galenandrew/wills-loft-bed/materials/materials-list.xlsx

Sheet: Buy list
Stock | Species / grade | Length | Qty | Unit | Notes
2x10 | TBD | 8 ft | 1 | board | 2 pieces total, longest 47
2x12 | TBD | 8 ft | 3 | board | 3 pieces total, longest 72¾
2x2 | TBD | 10 ft | 2 | board | 5 pieces total, longest 106¼ · LONGEST PIECE NEEDS A 10 FT BOARD · these two are ledge_cleat and ledge_cleat_rail; per the user they can be RIPPED from one 10 ft 2x4 instead
2x4 | TBD | 8 ft | 14 | board | 48 pieces total
2x4 | TBD | 10 ft | 1 | board | 48 pieces total, longest 104¾ · LONGEST PIECE NEEDS A 10 FT BOARD
2x8 | TBD | 8 ft | 1 | board | 4 pieces total, longest 23¼
poplar-2x2 | TBD | 8 ft | 8 | board | 23 pieces total, longest 26¼ · buy as poplar 8/4 S4S dressed to 1½ x 1½, or clear/select pine at that section — ONE board, no splice
poplar-2x4 | TBD | 10 ft | 1 | board | 1 pieces total, longest 107 · LONGEST PIECE NEEDS A 10 FT BOARD · buy as poplar 8/4 S4S dressed to 1½ x 3½, or clear/select pine at that section — ONE board, no splice
ply-1/2 | TBD | 4 x 8 sheet | 5 | sheet | 19 pieces nested at 61% of sheet area; 62.08 sq ft offcut · see the sheet nest — the Cut layout tab here, the Cut list page on the site
ply-3/4 paint-grade | TBD | 4 x 8 sheet | 4 | sheet | 22 pieces nested at 73% of sheet area; 34 1/16 sq ft offcut · see the sheet nest — the Cut layout tab here, the Cut list page on the site
lvl-2x14 | LVL (1 3/4 x 14) | 10 ft preferred | 1 | board | the beam is ONE 106 1/4 notched board. Home Depot stocks 14 ft (LPLVL14-14) which works with 62 in of waste; a yard 10 ft is the clean buy. Do NOT cut it to two pieces.

Sheet: Cut list
Part | Qty | Assembly | Stock | Length | Width | Thick | Source | Notes
hw_header#2x10-loft, hw_header#2x10-stair | 2 | half_wall | 2x10 | 47 | 9¼ | 1½ | lamination of hw_header
stringer_a, stringer_b, stringer_c | 3 | stair | 2x12 | 72¾ | 11¼ | 1½ | yaml member | true notched profile, not the yaml bbox; INCLINED: 72¾ up the rake, and the bbox is not the board
ledge_cleat, ledge_cleat_rail | 2 | loft | 2x2 | 106¼ | 1½ | 1½ | yaml member
ledge_strut[0], ledge_strut[1], ledge_strut[2] | 3 | loft | 2x2 | 5¾ | 1½ | 1½ | yaml member
rear_ledger | 1 | loft | 2x4 | 104¾ | 3½ | 1½ | yaml member
hw_top_plate_1, hw_top_plate_2 | 2 | half_wall | 2x4 | 50 | 3½ | 1½ | yaml member
side_ledger | 1 | loft | 2x4 | 50 | 3½ | 1½ | yaml member
hw_king_a, hw_king_b | 2 | half_wall | 2x4 | 49¼ | 3½ | 1½ | yaml member
deck_joist[0] | 1 | loft | 2x4 | 48½ | 3½ | 1½ | yaml member | one notched board; the yaml carries it as deck_joist[0], deck_joist_tail
deck_joist[1], deck_joist[2], deck_joist[3], deck_joist[4], deck_joist[5], deck_joist[6], deck_joist[7], deck_joist[8], deck_rim | 9 | loft | 2x4 | 46¾ | 3½ | 1½ | yaml member
hw_trimmer_a, hw_trimmer_b | 2 | half_wall | 2x4 | 40 | 3½ | 1½ | yaml member
nk_bedwall_stud[0], nk_bedwall_stud[1], nk_bedwall_stud[2] | 3 | nook | 2x4 | 38½ | 3½ | 1½ | yaml member
hw_rake_nailer | 1 | half_wall | 2x4 | 38 5/16 | 3½ | 1½ | yaml member | true raked profile, not the yaml bbox; INCLINED: 38 5/16 up the rake, and the bbox is not the board
hw_bottom_plate_a, hw_bottom_plate_b | 2 | half_wall | 2x4 | 28¼ | 3½ | 1½ | yaml member
kicker | 1 | stair | 2x4 | 24¾ | 3½ | 1½ | yaml member
nk_bedwall_cap | 1 | nook | 2x4 | 24¾ | 3½ | 1½ | yaml member
lnd_joist[0], lnd_joist[1] | 2 | stair | 2x4 | 15 | 3½ | 1½ | yaml member
nk_shortwall_strut[0], nk_shortwall_strut[1], nk_shortwall_strut[2] | 3 | nook | 2x4 | 14.11 | 3½ | 1½ | yaml member | true raked profile, not the yaml bbox
stringer_a_skin_cleat | 1 | stair | 2x4 | 13.53 | 3½ | 1½ | yaml member | true raked profile, not the yaml bbox
deck_blocking[0], deck_blocking[1], deck_blocking[2], deck_blocking[3], deck_blocking[4], deck_blocking[5], deck_blocking[6], deck_blocking[7], deck_seam_blocking[0], deck_seam_blocking[1], deck_seam_blocking[2], deck_seam_blocking[3], deck_seam_blocking[4] | 13 | loft | 2x4 | 10½ | 3½ | 1½ | yaml member
lnd_blocking[0], lnd_blocking[1] | 2 | stair | 2x4 | 10 1/8 | 3½ | 1½ | yaml member
deck_blocking_end | 1 | loft | 2x4 | 5¾ | 3½ | 1½ | yaml member
lnd_ledger_bedwall, lnd_rim | 2 | stair | 2x8 | 23¼ | 7¼ | 1½ | yaml member
lnd_ledger_rightwall | 1 | stair | 2x8 | 18 | 7¼ | 1½ | yaml member
lnd_side_member | 1 | stair | 2x8 | 15 | 7¼ | 1½ | yaml member
beam | 1 | loft | lvl-2x14 | 106¼ | 14 | 1¾ | yaml member | one notched board; the yaml carries it as beam, beam_tongue
beam_wrap_face | 1 | loft | ply-1/2 | 107 | 14½ | ½ | yaml member | CUT AS 2 PIECES: 53½×14½ + 53½×14½ — joint on x 53 1/2, over deck_joist[4]
beam_wrap_top | 1 | loft | ply-1/2 | 107 | 2¾ | ½ | yaml member | CUT AS 2 PIECES: 53½×2¾ + 53½×2¾ — joint on x 53 1/2, with the face wrap
beam_wrap_inner | 1 | loft | ply-1/2 | 106¼ | 9¾ | ½ | yaml member | CUT AS 2 PIECES: 53 1/8×9¾ + 53 1/8×9¾ — joint on x 53 1/8, the ledge's joint line
loft_ceiling | 1 | loft | ply-1/2 | 102¼ | 50 | ½ | yaml member | CUT AS 3 PIECES: 38¼×50 + 36×50 + 28×50 — three pieces, seams on the joist centres at 38¼ and 74¼ — every ceiling seam is backed by a joist; clear of all downlights. Rev AZ: 1/2 ply, and 102¼ long not 102 — the half-wall's loft face went to 1/2 with it, so the last piece grew 1/4
hw_sheath_loft_a | 1 | half_wall | ply-1/2 | 53¾ | 4¼ | ½ | yaml member
hw_sheath_loft_head | 1 | half_wall | ply-1/2 | 53¾ | 45¾ | ½ | yaml member | one notched board; the yaml carries it as hw_sheath_loft_head, hw_sheath_loft_b
hw_end_cap | 1 | half_wall | ply-1/2 | 53¼ | 4¾ | ½ | yaml member | one notched board; the yaml carries it as hw_end_cap, hw_end_cap_foot
hw_header#ply-1/2 | 1 | half_wall | ply-1/2 | 47 | 9¼ | ½ | lamination of hw_header
hw_jamb_ply_a, hw_jamb_ply_b | 2 | half_wall | ply-1/2 | 40 | 3½ | ½ | yaml member
nk_soffit_rake | 1 | nook | ply-1/2 | 37.97 | 28¼ | ½ | yaml member | true raked profile, not the yaml bbox; INCLINED: 37.97 up the rake, and the bbox is not the board
nk_soffit_flat | 1 | nook | ply-1/2 | 28¼ | 14.01 | ½ | yaml member
nk_wrap_shortwall | 1 | nook | ply-1/2 | 28¼ | 16.07 | ½ | yaml member | true raked profile, not the yaml bbox
stringer_a_skin | 1 | stair | ply-1/2 | 24 | 22 | ½ | yaml member | true stepped outline, not the yaml bbox
ledge_lid | 1 | loft | ply-3/4 | 107 | 8 | ¾ | yaml member | CUT AS 2 PIECES: 53 1/8×8 + 53 7/8×8 — joint on x 53 1/8, over ledge_strut[1]; no splice needed
deck_ply | 1 | loft | ply-3/4 | 106¼ | 48¼ | ¾ | yaml member | CUT AS 3 PIECES: 62¼×24 + 62¼×24¼ + 44×48¼ — two rows to x 62¼ either side of the y-24 seam, then one full-depth 44 x 48¼ panel over the landing end; seam on joist 5's centre — all derived from the blocking
ledge_front_rail | 1 | loft | ply-3/4 | 106¼ | 10¼ | ¾ | yaml member | CUT AS 2 PIECES: 53 1/8×10¼ + 53 1/8×10¼ — joint on x 53 1/8 = centre of ledge_strut[1], backed by ledge_rail_splice
hw_sheath_stair | 1 | half_wall | ply-3/4 | 50 | 44¼ | ¾ | yaml member | one notched board; the yaml carries it as hw_sheath_stair, ledge_end_cap, beam_end_cap
nk_wrap_bedwall | 1 | nook | ply-3/4 | 41½ | 28¼ | ¾ | yaml member
lnd_ply | 1 | stair | ply-3/4 | 27 7/8 | 24 | ¾ | yaml member
riser[1] | 1 | stair | ply-3/4 | 25¼ | 7½ | ¾ | DERIVED in cad/model.py — not a yaml member | riser scheme: standard
riser[2], riser[3] | 2 | stair | ply-3/4 | 25¼ | 8¼ | ¾ | DERIVED in cad/model.py — not a yaml member | riser scheme: standard
tread[1] | 1 | stair | ply-3/4 | 25¼ | 9 1/8 | ¾ | DERIVED in cad/model.py — not a yaml member | 5 from the top; 1/8 nose past the riser
tread[2] | 1 | stair | ply-3/4 | 25¼ | 9 1/8 | ¾ | DERIVED in cad/model.py — not a yaml member | 4 from the top; 1/8 nose past the riser
tread[3] | 1 | stair | ply-3/4 | 25¼ | 9 1/8 | ¾ | DERIVED in cad/model.py — not a yaml member | 3 from the top; 1/8 nose past the riser; notched 3/4 at the half-wall end
riser[4], riser[5] | 2 | stair | ply-3/4 | 24 | 8¼ | ¾ | DERIVED in cad/model.py — not a yaml member | riser scheme: standard
riser[6] | 1 | stair | ply-3/4 | 24 | 8¼ | ¾ | DERIVED in cad/model.py — not a yaml member | landing face
tread[4] | 1 | stair | ply-3/4 | 24 | 9 1/8 | ¾ | DERIVED in cad/model.py — not a yaml member | 2 from the top; 1/8 nose past the riser
tread[5] | 1 | stair | ply-3/4 | 24 | 9 1/8 | ¾ | DERIVED in cad/model.py — not a yaml member | 1 from the top; 1/8 nose past the riser
ledge_rail_splice | 1 | loft | ply-3/4 | 10 | 7¼ | ¾ | yaml member
slat[0..22] | 23 | screen | poplar-2x2 | 26¼ | 1½ | 1½ | yaml member
screen_top_plate | 1 | screen | poplar-2x4 | 107 | 3½ | 1½ | yaml member

Sheet: Sheet goods
Panel | Stock | Long | Short | From a split? | Notes / joint
hw_sheath_loft_a | ply-1/2 | 53¾ | 4¼
hw_sheath_loft_head | ply-1/2 | 53¾ | 45¾ |  | one notched board; the yaml carries it as hw_sheath_loft_head, hw_sheath_loft_b
beam_wrap_face pc1 | ply-1/2 | 53½ | 14½ | YES | joint on x 53 1/2, over deck_joist[4]
beam_wrap_face pc2 | ply-1/2 | 53½ | 14½ | YES | joint on x 53 1/2, over deck_joist[4]
beam_wrap_top pc1 | ply-1/2 | 53½ | 2¾ | YES | joint on x 53 1/2, with the face wrap
beam_wrap_top pc2 | ply-1/2 | 53½ | 2¾ | YES | joint on x 53 1/2, with the face wrap
hw_end_cap | ply-1/2 | 53¼ | 4¾ |  | one notched board; the yaml carries it as hw_end_cap, hw_end_cap_foot
beam_wrap_inner pc1 | ply-1/2 | 53 1/8 | 9¾ | YES | joint on x 53 1/8, the ledge's joint line
beam_wrap_inner pc2 | ply-1/2 | 53 1/8 | 9¾ | YES | joint on x 53 1/8, the ledge's joint line
loft_ceiling pc1 | ply-1/2 | 50 | 38¼ | YES | three pieces, seams on the joist centres at 38¼ and 74¼ — every ceiling seam is backed by a joist; clear of all downlights. Rev AZ: 1/2 ply, and 102¼ long not 102 — the half-wall's loft face went to 1/2 with it, so the last piece grew 1/4
loft_ceiling pc2 | ply-1/2 | 50 | 36 | YES | three pieces, seams on the joist centres at 38¼ and 74¼ — every ceiling seam is backed by a joist; clear of all downlights. Rev AZ: 1/2 ply, and 102¼ long not 102 — the half-wall's loft face went to 1/2 with it, so the last piece grew 1/4
loft_ceiling pc3 | ply-1/2 | 50 | 28 | YES | three pieces, seams on the joist centres at 38¼ and 74¼ — every ceiling seam is backed by a joist; clear of all downlights. Rev AZ: 1/2 ply, and 102¼ long not 102 — the half-wall's loft face went to 1/2 with it, so the last piece grew 1/4
hw_header#ply-1/2 | ply-1/2 | 47 | 9¼ |  | lamination of hw_header
hw_jamb_ply_a | ply-1/2 | 40 | 3½
hw_jamb_ply_b | ply-1/2 | 40 | 3½
nk_soffit_rake | ply-1/2 | 37.97 | 28¼ |  | true raked profile, not the yaml bbox; INCLINED: 37.97 up the rake, and the bbox is not the board
nk_soffit_flat | ply-1/2 | 28¼ | 14.01
nk_wrap_shortwall | ply-1/2 | 28¼ | 16.07 |  | true raked profile, not the yaml bbox
stringer_a_skin | ply-1/2 | 24 | 22 |  | true stepped outline, not the yaml bbox
deck_ply pc1 | ply-3/4 | 62¼ | 24 | YES | two rows to x 62¼ either side of the y-24 seam, then one full-depth 44 x 48¼ panel over the landing end; seam on joist 5's centre — all derived from the blocking
deck_ply pc2 | ply-3/4 | 62¼ | 24¼ | YES | two rows to x 62¼ either side of the y-24 seam, then one full-depth 44 x 48¼ panel over the landing end; seam on joist 5's centre — all derived from the blocking
ledge_lid pc2 | ply-3/4 | 53 7/8 | 8 | YES | joint on x 53 1/8, over ledge_strut[1]; no splice needed
ledge_lid pc1 | ply-3/4 | 53 1/8 | 8 | YES | joint on x 53 1/8, over ledge_strut[1]; no splice needed
ledge_front_rail pc1 | ply-3/4 | 53 1/8 | 10¼ | YES | joint on x 53 1/8 = centre of ledge_strut[1], backed by ledge_rail_splice
ledge_front_rail pc2 | ply-3/4 | 53 1/8 | 10¼ | YES | joint on x 53 1/8 = centre of ledge_strut[1], backed by ledge_rail_splice
hw_sheath_stair | ply-3/4 | 50 | 44¼ |  | one notched board; the yaml carries it as hw_sheath_stair, ledge_end_cap, beam_end_cap
deck_ply pc3 | ply-3/4 | 48¼ | 44 | YES | two rows to x 62¼ either side of the y-24 seam, then one full-depth 44 x 48¼ panel over the landing end; seam on joist 5's centre — all derived from the blocking
nk_wrap_bedwall | ply-3/4 | 41½ | 28¼
lnd_ply | ply-3/4 | 27 7/8 | 24
riser[1] | ply-3/4 | 25¼ | 7½ |  | riser scheme: standard
riser[2] | ply-3/4 | 25¼ | 8¼ |  | riser scheme: standard
riser[3] | ply-3/4 | 25¼ | 8¼ |  | riser scheme: standard
tread[1] | ply-3/4 | 25¼ | 9 1/8 |  | 5 from the top; 1/8 nose past the riser
tread[2] | ply-3/4 | 25¼ | 9 1/8 |  | 4 from the top; 1/8 nose past the riser
tread[3] | ply-3/4 | 25¼ | 9 1/8 |  | 3 from the top; 1/8 nose past the riser; notched 3/4 at the half-wall end
riser[4] | ply-3/4 | 24 | 8¼ |  | riser scheme: standard
riser[5] | ply-3/4 | 24 | 8¼ |  | riser scheme: standard
riser[6] | ply-3/4 | 24 | 8¼ |  | landing face
tread[4] | ply-3/4 | 24 | 9 1/8 |  | 2 from the top; 1/8 nose past the riser
tread[5] | ply-3/4 | 24 | 9 1/8 |  | 1 from the top; 1/8 nose past the riser
ledge_rail_splice | ply-3/4 | 10 | 7¼

Sheet: Cut layout
Grade | Sheet | Piece | W | H | From edge X | From edge Y | Grain | Flag
ply-1/2 | 1 | hw_sheath_loft_head | 45¾ | 53¾ | 0 | 0 | rotated
ply-1/2 | 1 | hw_header#ply-1/2 | 47 | 9¼ | 0 | 53 7/8
ply-1/2 | 1 | hw_jamb_ply_a | 40 | 3½ | 0 | 63¼
ply-1/2 | 1 | hw_jamb_ply_b | 40 | 3½ | 0 | 66 7/8
ply-1/2 | 1 | nk_wrap_shortwall | 28¼ | 16.07 | 0 | 70½
ply-1/2 | 2 | hw_sheath_loft_a | 4¼ | 53¾ | 0 | 0 | rotated
ply-1/2 | 2 | beam_wrap_face pc1 | 14½ | 53½ | 4 3/8 | 0 | rotated
ply-1/2 | 2 | beam_wrap_face pc2 | 14½ | 53½ | 19 | 0 | rotated
ply-1/2 | 2 | beam_wrap_top pc1 | 2¾ | 53½ | 33 5/8 | 0 | rotated
ply-1/2 | 2 | beam_wrap_top pc2 | 2¾ | 53½ | 36½ | 0 | rotated
ply-1/2 | 2 | hw_end_cap | 4¾ | 53¼ | 39 3/8 | 0 | rotated
ply-1/2 | 2 | nk_soffit_rake | 37.97 | 28¼ | 4 3/8 | 53 5/8
ply-1/2 | 3 | beam_wrap_inner pc1 | 9¾ | 53 1/8 | 0 | 0 | rotated
ply-1/2 | 3 | beam_wrap_inner pc2 | 9¾ | 53 1/8 | 9 7/8 | 0 | rotated
ply-1/2 | 3 | loft_ceiling pc3 | 28 | 50 | 19¾ | 0
ply-1/2 | 3 | nk_soffit_flat | 28¼ | 14.01 | 0 | 53¼
ply-1/2 | 3 | stringer_a_skin | 24 | 22 | 0 | 67.39
ply-1/2 | 4 | loft_ceiling pc1 | 38¼ | 50 | 0 | 0
ply-1/2 | 5 | loft_ceiling pc2 | 36 | 50 | 0 | 0
ply-3/4 paint-grade | 1 | deck_ply pc2 | 24¼ | 62¼ | 0 | 0 | rotated
ply-3/4 paint-grade | 1 | ledge_lid pc2 | 8 | 53 7/8 | 24 3/8 | 0 | rotated
ply-3/4 paint-grade | 1 | ledge_front_rail pc1 | 10¼ | 53 1/8 | 32½ | 0 | rotated
ply-3/4 paint-grade | 1 | ledge_rail_splice | 10 | 7¼ | 32½ | 53¼
ply-3/4 paint-grade | 1 | nk_wrap_bedwall | 41½ | 28¼ | 0 | 62 3/8
ply-3/4 paint-grade | 2 | deck_ply pc1 | 24 | 62¼ | 0 | 0 | rotated
ply-3/4 paint-grade | 2 | ledge_front_rail pc2 | 10¼ | 53 1/8 | 24 1/8 | 0 | rotated
ply-3/4 paint-grade | 2 | ledge_lid pc1 | 8 | 53 1/8 | 34½ | 0 | rotated
ply-3/4 paint-grade | 2 | lnd_ply | 27 7/8 | 24 | 0 | 62 3/8
ply-3/4 paint-grade | 2 | tread[2] | 9 1/8 | 25¼ | 28 | 62 3/8 | rotated
ply-3/4 paint-grade | 2 | tread[3] | 9 1/8 | 25¼ | 37¼ | 62 3/8 | rotated
ply-3/4 paint-grade | 2 | tread[1] | 25¼ | 9 1/8 | 0 | 86½
ply-3/4 paint-grade | 3 | hw_sheath_stair | 44¼ | 50 | 0 | 0 | rotated
ply-3/4 paint-grade | 3 | riser[2] | 25¼ | 8¼ | 0 | 50 1/8
ply-3/4 paint-grade | 3 | riser[3] | 25¼ | 8¼ | 0 | 58½
ply-3/4 paint-grade | 3 | riser[1] | 25¼ | 7½ | 0 | 66 7/8
ply-3/4 paint-grade | 3 | riser[4] | 8¼ | 24 | 25 3/8 | 66 7/8 | rotated
ply-3/4 paint-grade | 3 | riser[5] | 8¼ | 24 | 33¾ | 66 7/8 | rotated
ply-3/4 paint-grade | 3 | tread[4] | 24 | 9 1/8 | 0 | 74½
ply-3/4 paint-grade | 3 | tread[5] | 24 | 9 1/8 | 0 | 83¾
ply-3/4 paint-grade | 4 | deck_ply pc3 | 44 | 48¼ | 0 | 0
ply-3/4 paint-grade | 4 | riser[6] | 24 | 8¼ | 0 | 48 3/8

Sheet: Hardware
Connection / item | Qty | Type | Fastener spec
LUS24 | 21 | Simpson
HUC28 | 2 | Simpson
A35 | 2 | Simpson
deck_joist[*] -> rear_ledger | 9 | hanger | LUS24
deck_joist[*] -> beam | 8 | hanger | LUS24 with 10dx1-1/2 into the beam — 1-1/2 of nail in 1-3/4 of LVL, the thickness the hanger tables are written for. Rev AG settles what Rev T left open; joist[0] is excepted because it runs past the beam face to y 50 and is carried by the side ledger.
beam_tongue -> side_ledger | 1 | bearing | bears on the ledger top at 57.25 over 1-1/2 x 1-3/4. Pinned with 2 x 1/4 x 6 structural screws driven UP from below, through the ledger's 3-1/2 into 2-1/2 of LVL — set the ledger and joist 0 first, drop the beam on, then screw from the open bay under the deck. NOT from above, the way this row read before the Rev AG connection audit, a 4 in screw from the beam's top face at 67.75 dies at 63.75 and never leaves the beam.
beam_tongue -> deck_joist_tail | 1 | bearing | bears on the sistered joist top over 1-1/2 x 1-3/4. Pinned the same way as the ledger half — 2 x 1/4 x 6 up through the joist tail from below. Ledger + joist together give the notched end 3 x 1-3/4 = 5.25 sq in, about 115 psi.
deck_joist[0] -> side_ledger | 1 | face-screw | 1/4 x 3 structural screws, two rows at 8 in o.c. over the whole 46-3/4 sister, with 4 in the last 12 — this is the path that takes joist[0]'s half of the beam reaction into the wall
deck_blocking[*] -> beam | 8 | face-screw | 2 x 1/4 x 3 structural screws per block at z 54 1/4 and 56 3/4, driven from the beam's OUTBOARD face at y 50 through 1 3/4 of LVL and 1 1/4 into the block. Rev AY: the z is stated because beam_wrap_face's structural rows come through the same face at the same x stations - keep them off each other. Rev AU: preferred over toe-screwing from inside the bay because it puts the fastener in shear instead of relying on a toed screw, and the y-50 face is open until beam_wrap_face goes on - the heads end up behind the wrap. SEQUENCE: before the wrap, and before the deck ply.
deck_blocking_end -> beam | 1 | face-screw | 2 x 1/4 x 3 structural screws from the beam's outboard face, as deck_blocking
deck_ply -> deck_blocking[*] | 8 | bearing | construction adhesive + #8 x 1-5/8 at 6 in o.c. along the front edge - the point of the blocking. This is the deck diaphragm's only continuous connection toward the beam (Rev AU)
deck_ply -> deck_blocking_end | 1 | bearing | construction adhesive + #8 x 1-5/8 at 6 in o.c., as deck_blocking
deck_seam_blocking[0] -> deck_joist[0] | 1 | face-screw | 2 x 3 in screws toe-driven into deck_joist[0]
deck_seam_blocking[0] -> deck_joist[1] | 1 | face-screw | 2 x 3 in screws toe-driven into deck_joist[1]. Rev AY: the far end used to be asserted in the other row's note and never checked. The block has no bearing shelf - it hangs at z 55.75-57.25 on toe-screws at BOTH ends - so both ends carry, and both are now declared.
deck_seam_blocking[1] -> deck_joist[1] | 1 | face-screw | 2 x 3 in screws toe-driven into deck_joist[1]
deck_seam_blocking[1] -> deck_joist[2] | 1 | face-screw | 2 x 3 in screws toe-driven into deck_joist[2]. Rev AY: the far end used to be asserted in the other row's note and never checked. The block has no bearing shelf - it hangs at z 55.75-57.25 on toe-screws at BOTH ends - so both ends carry, and both are now declared.
deck_seam_blocking[2] -> deck_joist[2] | 1 | face-screw | 2 x 3 in screws toe-driven into deck_joist[2]
deck_seam_blocking[2] -> deck_joist[3] | 1 | face-screw | 2 x 3 in screws toe-driven into deck_joist[3]. Rev AY: the far end used to be asserted in the other row's note and never checked. The block has no bearing shelf - it hangs at z 55.75-57.25 on toe-screws at BOTH ends - so both ends carry, and both are now declared.
deck_seam_blocking[3] -> deck_joist[3] | 1 | face-screw | 2 x 3 in screws toe-driven into deck_joist[3]
deck_seam_blocking[3] -> deck_joist[4] | 1 | face-screw | 2 x 3 in screws toe-driven into deck_joist[4]. Rev AY: the far end used to be asserted in the other row's note and never checked. The block has no bearing shelf - it hangs at z 55.75-57.25 on toe-screws at BOTH ends - so both ends carry, and both are now declared.
deck_seam_blocking[4] -> deck_joist[4] | 1 | face-screw | 2 x 3 in screws toe-driven into deck_joist[4]
deck_seam_blocking[4] -> deck_joist[5] | 1 | face-screw | 2 x 3 in screws toe-driven into deck_joist[5]. Rev AY: the far end used to be asserted in the other row's note and never checked. The block has no bearing shelf - it hangs at z 55.75-57.25 on toe-screws at BOTH ends - so both ends carry, and both are now declared.
deck_ply -> deck_seam_blocking[*] | 5 | bearing | construction adhesive + #8 x 1-5/8 at 6 in o.c. through BOTH panel edges - the seam is a butt joint in the deck diaphragm and both sides land on this block (Rev AV)
deck_ply -> side_ledger | 1 | bearing | construction adhesive + #8 x 1-5/8 at 6 in o.c. — structural, not just an edge fixing, because the ply diaphragm is what keeps the shallow ledger from rolling under the beam's eccentric load
deck_ply -> rear_ledger | 1 | bearing | construction adhesive + #8 x 1-5/8 at 6 in o.c., same as the side ledger — Rev AO drops rear_ledger to deck level so the ply runs over its top the same way
beam -> hw_top_plate_2 | 1 | bearing | NO FASTENER KEY — silent in verify.py, which only reports the rows that say UNSPECIFIED
deck_rim -> hw_top_plate_2 | 1 | bearing | NO FASTENER KEY — silent in verify.py, which only reports the rows that say UNSPECIFIED
rear_ledger -> wall:bed | 1 | wall | 3/8 x 4 lags, 2 per stud staggered, into every stud - the same fastener as lnd_ledger_bedwall. Rev AS: was the sizeless 'lags into every stud'. 1 1/2 of 2x4 ledger + 5/8 of board = 2 1/8 crossed, 1 7/8 of embedment.
side_ledger -> wall:window | 1 | wall | 1/4 x 4 structural screws, 2 per stud staggered top and bottom, plus a pair within 6 in of y 50 — FIELD, confirm a stud lands there or add blocking in the wall
hw_header -> hw_trimmer_a | 1 | bearing | NO FASTENER KEY — silent in verify.py, which only reports the rows that say UNSPECIFIED
hw_header -> hw_trimmer_b | 1 | bearing | NO FASTENER KEY — silent in verify.py, which only reports the rows that say UNSPECIFIED
hw_jamb_ply_a -> hw_bottom_plate_a | 1 | bearing | bears with the trimmer; held by the pack nailing below
hw_jamb_ply_b -> hw_bottom_plate_b | 1 | bearing | bears with the trimmer; held by the pack nailing below
hw_trimmer_a -> hw_king_a | 1 | face-screw | 16d nails in two rows at 12 in o.c. + construction adhesive on both faces of the ply — this is what makes the pack act as one 3.5 post
hw_trimmer_b -> hw_king_b | 1 | face-screw | 16d nails in two rows at 12 in o.c. + construction adhesive on both faces of the ply — this is what makes the pack act as one 3.5 post
hw_top_plate_2 -> hw_top_plate_1 | 1 | bearing | 16d at 16 in o.c., staggered — the upper plate laps the lower at the wall's ends
hw_king_a -> hw_bottom_plate_a | 1 | bearing | 2 x 3 in screws toe-driven, or end-nailed 2 x 16d through the plate
hw_king_b -> hw_bottom_plate_b | 1 | bearing | 2 x 3 in screws toe-driven, or end-nailed 2 x 16d through the plate. This is the stud the beam's stair-end reaction comes down; Rev AG's connection audit found the post asserted in prose and never declared.
hw_top_plate_1 -> hw_header | 1 | bearing | NO FASTENER KEY — silent in verify.py, which only reports the rows that say UNSPECIFIED
hw_top_plate_1 -> hw_king_a | 1 | bearing | NO FASTENER KEY — silent in verify.py, which only reports the rows that say UNSPECIFIED
hw_top_plate_1 -> hw_king_b | 1 | bearing | NO FASTENER KEY — silent in verify.py, which only reports the rows that say UNSPECIFIED
hw_bottom_plate_a -> floor | 1 | floor | 6 x #10 x 3 in screws into the subfloor at roughly 6 in o.c. across the 28 1/4 run. Rev BB: same builder's call as the kicker — into the plywood regardless of joist location, since the half-wall framing this plate carries is already tied into the bed wall and window wall.
hw_bottom_plate_b -> floor | 1 | floor | 6 x #10 x 3 in screws into the subfloor at roughly 6 in o.c. across the 28 1/4 run. Rev BB: same builder's call as hw_bottom_plate_a.
nk_bedwall_stud[*] -> hw_bottom_plate_a | 3 | bearing | 2 x 3 in screws toe-driven each stud
nk_bedwall_cap -> nk_bedwall_stud[*] | 3 | bearing | 2 x 3 in screws through the cap into each stud
lnd_ledger_bedwall -> nk_bedwall_cap | 1 | bearing | 3 in screws up through the cap into the ledger at each stud — secondary only, the ledger's own load path is its lags into the bed-wall studs
lnd_ledger_rightwall -> nk_bedwall_cap | 1 | bearing | 3 in screws up through the cap, at the cap's right-hand end
lnd_side_member -> nk_bedwall_cap | 1 | bearing | 2 x 3 in screws up through the cap into the side member
nk_shortwall_strut[*] -> hw_bottom_plate_b | 3 | bearing | 2 x 3 in screws toe-driven each strut
hw_rake_nailer -> hw_trimmer_b | 1 | face-screw | 3 x 3 in screws through the trimmer into the nailer's end
lnd_side_member -> hw_header | 1 | face-screw | 6 × 1/4 × 4 structural screws. Rev AE: direct into the header, no 3/4 facing in the path, so 4 in reaches the depth 5 in used to.
lnd_ledger_rightwall -> wall:right | 1 | wall | 1/4 x 4 flat-head structural screws (SDWS22400 or equal), 2 per stud staggered. Rev AS: the wall is 5/8 drywall on wood studs, so a screw crosses 1 1/2 of 2x8 ledger + 5/8 of board = 2 1/8 before it reaches the stud; a 4 leaves 1 7/8 of embedment. Do not substitute 3 1/2 here - that is only 1 3/8 in the stud.
stringer_c -> wall:right | 1 | wall | 1/4 x 4 flat-head structural screws, 2 per stud into every stud the stringer crosses. Rev AS: was the bare Rev T phrase 'fastens to the right wall', which specified nothing. Same 2 1/8 of ledger + board to cross as lnd_ledger_rightwall.
stringer_a_skin -> stringer_a | 1 | face-screw | construction adhesive + 1-1/2 x 16ga finish nails at 8 in o.c. into the stringer's outer face (1 in penetration through the 1/2 skin; was 3/4 through 3/4)
stringer_a_skin_cleat -> stringer_a_skin | 1 | face-screw | 1-1/2 x 16ga finish nails at 8 in o.c. through the skin into the cleat, plus adhesive
stringer_a_skin_cleat -> hw_bottom_plate_b | 1 | face-screw | 2 x #10 x 3 screws through the plate's end into the cleat
stringer_a_skin_cleat -> stringer_a | 1 | bearing | adhesive + 3 x #10 x 2-1/2 screws up through the cleat's ripped top into the stringer, over the 5 in of angled contact at its downhill end
stringer_a_skin_cleat -> floor | 1 | floor | 3 x #10 x 3 screws into the subfloor
kicker -> floor | 1 | floor | 5 x #10 x 3 in screws into the subfloor, roughly 6 in o.c. across the 24 3/4 run. Floor joist location not measured and not required here: the builder's call (Rev BB) is to fasten straight into the plywood subfloor regardless of where the joists fall, since the framing is tied into all three walls in several other places and does not depend on this fixing to stay put.
stringer_a -> kicker | 1 | bearing | 2 x 3 in screws toe-driven into the kicker
stringer_b -> kicker | 1 | bearing | 2 x 3 in screws toe-driven into the kicker
stringer_c -> kicker | 1 | bearing | 2 x 3 in screws toe-driven into the kicker
loft_ceiling -> deck_joist[*] | 9 | face-screw | construction adhesive + #8 x 2 at 8 in o.c. up into each joist's 1-1/2 bottom edge - 1/2 of ply then 1-1/2 into 3-1/2 of joist (Rev AZ: 1/2 ply, so the same screw takes 1/4 MORE embedment). Rev AT: the panel had NO connection row of any kind before this.
loft_ceiling -> rear_ledger | 1 | face-screw | construction adhesive + #8 x 2 at 8 in o.c. into the ledger's bottom edge
loft_ceiling -> side_ledger | 1 | face-screw | construction adhesive + #8 x 2 at 6 in o.c. into the ledger's bottom edge over the whole 50. Rev AT: tighter than the 8 in field spacing because this is the anchored side of the notch tie - see the beam row below.
loft_ceiling -> deck_joist_tail | 1 | face-screw | construction adhesive + 2 x #8 x 2 into the tail's 1-3/4 of bottom edge, the other anchored side of the notch tie (Rev AT)
loft_ceiling -> beam | 1 | face-screw | construction adhesive + #8 x 2 at 6 in o.c. into the beam's bottom edge over x 3 to 27, then 12 in o.c. beyond. Rev AT: this is the SECOND notch restraint, and it acts in the direction the notch would actually fail. A split from the corner at x 3, z 57.25 runs in +x along the grain, and the piece it separates is the beam's bottom 3-1/2 beyond x 3 - whose bottom face is this z 53.75 line. The same sheet is screwed to side_ledger and deck_joist_tail on the other side of x 3, both solidly bearing, so it is a continuous tie holding that piece up against members that cannot move. It is SECONDARY to beam_wrap_face, which is in the plane of the split and works in shear; this works in screw withdrawal from a 1-3/4 landing that is the LVL's LAMINATED EDGE - screws there cross glue lines, so use the stated spacing, do not over-torque, and do not treat this as the primary. Both go on late, so neither is present while the loft is being framed.
beam_wrap_face -> beam | 1 | face-screw | construction adhesive + #8 x 2 at 12 in o.c. in two rows into the LVL - 1/2 of ply then 1-1/2 into 1-3/4 of beam (Rev AZ: the splice screws GAINED 1/4 of embedment on the thinner panel; nothing about the splice got weaker). Rev AT: OVER x 0 TO 27 THIS IS STRUCTURAL, not a finish fixing: tighten to 6 in o.c. in two rows and glue the full contact area. This panel is the notch reinforcement (see beam_tongue) - it straddles the re-entrant corner at x 3, z 57.25 and runs the full length past the shoulder, so it carries across the corner in shear what the LVL would otherwise carry in cross-grain tension. Keep every screw at least 1 in clear of the corner and out of the notch void below z 57.25 at x 0-3. Rev AT: the wrap had no connection row at all before this - its fixing was never specified and never checked.
beam_wrap_face -> beam_tongue | 1 | face-screw | glue only over x 0 to 3 - no screws within 1 in of the notch corner at x 3, z 57.25, which is what the beam row already says. Rev AY: this row exists so the arithmetic covers the whole board. beam_tongue is part_of beam - the SAME LVL - but resolve() does not merge part_of members, so beam_wrap_face -> beam checked only 103 1/4 of the 106 1/4 and the 3 the splice exists to protect sat outside every overlap number reported. Found by connection-checker at Rev AX. No physical change: the wood is continuous across x 3 above z 57.25, and the tongue has its own verified gravity path onto side_ledger and deck_joist_tail.
beam_wrap_face -> side_ledger | 1 | face-screw | #8 x 2-1/2 at 6 in o.c. into the ledger's y-50 end face, over z 53.75-57.25. Rev AT: part of the notch splice - this is what ties the tongue back to the member it bears on. End-grain withdrawal is poor and irrelevant here: the joint works in shear. Rev AY: 2-1/2 not 2, for 1-3/4 of embedment instead of 1-1/4; Rev AZ makes it 2 on the 1/2 wrap. This is the anchor side of the whole splice claim and 1-1/4 of dowel action in end grain was thin.
beam_wrap_face -> deck_joist_tail | 1 | face-screw | #8 x 2-1/2 at 6 in o.c. into the tail's y-50 end face, over z 53.75-57.25 - the other half of the notch splice, into the joist sistered to the ledger (Rev AT; 2-1/2 since Rev AY, same end-grain reason as the ledger half)
beam_wrap_inner -> beam | 1 | face-screw | construction adhesive + #8 x 2 at 12 in o.c. into the LVL. Rev AT: finish fixing only - this panel starts at z 58, 3/4 above the notch corner, so it does no structural work and is not part of the splice. It had no connection row either.
beam_wrap_top -> beam | 1 | bearing | construction adhesive + #8 x 2 at 12 in o.c. into the LVL, between the slats. The cap is finish stock doing structural work - it is the slats' seat - so it is fixed on its own account, not by the slat screws alone.
slat[*] -> beam_wrap_top | 22 | bearing | 1 x #8 x 3 through the cap into the LVL — 1/2 of cap since Rev AZ, 2-1/2 into the beam. Rev AG settles what Rev T left open. slat[22] is the one exception - see below.
slat[22] -> beam_wrap_top | 1 | bearing | 1 x #8 x 3, OFFSET INBOARD. slat[22] runs x 105.5 to 107 and the LVL ends at 106.25, so only 3/4 of its 1-1/2 width has beam under the cap - the rest is over beam_end_cap, which is still 3/4 ply. A centred screw lands half in ply. Found by the kernel ray cast.
ledge_cleat -> wall:bed | 1 | wall | 2 x 3 in screws into every stud — it carries half an 8 wide lid and whatever is set on it, so it is fixed like a ledger, not tacked like trim
ledge_strut[*] -> ledge_cleat | 3 | face-screw | 2 x #8 x 2-1/2 toe-driven into the cleat, plus adhesive
ledge_strut[*] -> ledge_front_rail | 3 | face-screw | adhesive + 2 pocket screws from inside the well, angled out of the strut into the back of the rail. Pocket, not toe: a toe screw into the 3/4 rail from behind breaks out the face, and a screw through the rail's face lands in the strut's end grain. (Rev BA: said "3/4 of poplar"; the rail has been 3/4 paint-grade ply since Rev AS. Same detail, same reason - a ply face breaks out at least as readily.)
ledge_lid -> ledge_strut[*] | 3 | bearing | #8 x 1-1/4, 2 per strut, countersunk and filled
ledge_lid -> ledge_cleat | 1 | bearing | #8 x 1-1/4 at 12 in o.c., countersunk and filled — the lid is fixed, not hinged
ledge_cleat_rail -> ledge_front_rail | 1 | face-screw | construction adhesive + #8 x 1-1/4 at 12 in o.c. from inside the well, through the cleat into the rail — screwed from the back so nothing shows on the face
ledge_cleat_rail -> deck_ply | 1 | bearing | construction adhesive + #10 x 3-1/2 down through the cleat and the ply into a joist at each of the 9 joists, and #8 x 2 into the ply between them
ledge_lid -> ledge_front_rail | 1 | bearing | #8 x 1-1/4 at 12 in o.c. into the rail's 3/4 top edge, countersunk and filled. Rev AM: the lid is fixed, never hinged, so this joint is permanent - and with the three struts holding the rail's top on 7.25 it is a flush line the whole 106 1/4, not a joint that has to be pulled closed at assembly.
ledge_rail_splice -> ledge_front_rail | 1 | face-screw | construction adhesive + #8 x 1-1/4 at 6 in o.c. in two rows, from inside the well through the splice into the back of both rail pieces - 1/2 into the rail's 3/4
ledge_lid -> ledge_end_cap | 1 | bearing | #8 x 1-1/4, 2 off — the 3/4 x 8 of skirt top edge the lid laps at the stair end (Rev AH)
screen_top_plate -> slat[*] | 23 | bearing | construction adhesive + 1 x #8 x 2-1/2 angled up through the slat into the plate, driven from the loft side, countersunk and filled; 2 x 1-1/2 16ga pins each slat to hold it while the adhesive cures. Rev AS: was UNSPECIFIED. 16ga alone was proposed and is not enough - the structure table calls this screen the GUARD for a 58 deck, and the ceiling note says a 200 lb lean at its top overloads the slat bases. One real screw per slat at each end (the base already has #8 x 3 into the LVL) makes the top a positive connection; the pins are for assembly, not for load.
screen_top_plate -> ceiling | 1 | ceiling | into ceiling framing / blocking — joist location not yet measured
lnd_ledger_bedwall -> wall:bed | 1 | wall | 3/8 x 4 lags, 2 per stud
stringer_b -> lnd_rim | 1 | face-screw | 3 x 1/4 x 3-1/2 SDS from inside the box through the rim, before the deck goes on
stringer_c -> lnd_ledger_rightwall | 1 | face-screw | plumb cut on the ledger end + 4 x 1/4 x 4-1/2 SDS into right-wall studs
stringer_a -> hw_header | 1 | face-screw | 4 x 1/4 x 3-1/2 SDS over y 18-27. Rev AE: the stringer is on the framing now, not on 3/4 of ply, so a 3-1/2 buries 2 in the header.
stringer_a -> hw_king_b | 1 | face-screw | 2 x 1/4 x 3-1/2 SDS
stringer_a -> hw_trimmer_b | 1 | face-screw | 2 x 1/4 x 3-1/2 SDS. Rev AE: the stringer crosses the far jamb pack over z 12-24, so it catches the trimmer as well as the king.
hw_rake_nailer -> stringer_a | 1 | face-screw | construction adhesive + 6 x 3 in screws toe-driven through the nailer into the stringer's face. Rev AE: the nailer's raked end (1-1/2 x 30 on the slope) dies straight onto stringer A now that the sheathing between them is gone.
lnd_rim -> hw_header | 1 | hanger | HUC28 concealed-flange hanger, SD10212 screws straight into the header (flanges would foul the side member on an LUS). Rev AE: no 3/4 facing in the path.
lnd_rim -> lnd_ledger_rightwall | 1 | hanger | HUC28 concealed-flange hanger (an LUS flange would hang past the ledger end)
lnd_joist[*] -> lnd_ledger_bedwall | 2 | hanger | LUS24
lnd_joist[*] -> lnd_rim | 2 | hanger | LUS24 on the rim's back face
lnd_side_member -> lnd_rim | 1 | face-screw | 2 x A35 at the inside corner, installed before the joists
stringer_a -> lnd_rim | 1 | face-screw | 2 x 1/4 x 3-1/2 SDS toe-screwed from the stringer's outer face; the side member blocks access from inside the box
lnd_blocking[*] -> stringer_b | 2 | face-screw | 2 x 3 in screws each end, toe-driven

Sheet: TBD and assumptions
Kind | Item | Detail
SOURCE | Generated from dimensions.yaml rev BC.1 | tools/materials.py, off the same model verify.py and the CAD kernel read. Regenerate after ANY model change — nothing here updates itself, and a stale workbook looks exactly like a current one.
CLOSED | Deck and ceiling ply layouts, chosen for joinery (Rev AX) | The deck is THREE pieces: two rows to x 62 1/4 either side of a blocked cross-joist seam at y 24, then one full-depth 44 x 48 1/4 panel over the landing end with no seam in it — the part walked on rather than slept on. Both seams sit under the mattress; the long one lands on joist 5 and needs no blocking. 62 1/4 is the furthest in it can go: the next joist would need a 56 wide panel against a 48 sheet width. The ceiling is three pieces with BOTH seams on joist centres (38 1/4, 74 1/4), so every ceiling seam is backed. Trimming the deck to a flat 48 was considered and rejected — it changed no sheet count and would have left beam_wrap_inner's foot over a 1/4 void. COST, stated plainly: these layouts are 9 sheets at 64%. The cheapest nest was 7 at 83%, with a full-width deck seam and a cross-joist seam in the ceiling. Two sheets bought better joinery, knowingly.
CLOSED | The loft deck IS the finished walking surface (2026-09-07) | The mattress covers y 8 3/4 to 46 3/4 out to about x 77; the rest is walked on and nothing in the model covers it, so the deck is the finished floor and takes a sanded paintable face rather than rated sheathing. Consequence: there is no hidden 3/4 ply left in the build, so the two grade groups collapsed to ONE paint-grade pool — and the sheet count assumes that. Buying the deck as sheathing again would break the nest, not just change the price.
GRADE | Every species/grade cell says TBD | Pending price and availability. TWO ply grades, not three: one 3/4 paint-grade pool covering every 3/4 piece including the deck, and 1/2 flitches for the jamb packs and the header's middle ply. Framing species/grade and the slat stock are also open.
CLOSED | Deck-ply front-edge blocking is now in the model (Rev AU) | Nine 2x4 blocks on edge at the beam face — eight at 10 1/2 on a 12 pitch plus one 5 3/4 at the rim, all from one 8 ft board, and they are counted in the Buy list and the Cut list. Fixed with 2 x 1/4 x 3 per block driven from the beam's OUTBOARD face before beam_wrap_face closes it, then the ply glued and screwed down onto them at 6 in o.c. SEQUENCE: before the deck ply.
CLOSED | The beam notch needs no separate ply cheek (Rev AT) | It is beam_wrap_face, which already spans the corner on the clear outboard face: adhesive + #8 x 2 at 6 in o.c. over x 0-27, into the tongue above z 57 1/4 and into the ledger and joist-tail end faces below it. Nothing extra to buy — but the wrap's fixing over that first 27 in is STRUCTURAL, not finish, and its screws must stay 1 in clear of the corner and out of the notch void below z 57 1/4.
FIELD | Stud locations: bed wall, window wall, right wall | Every ledger fixing count on the Hardware tab assumes 16 in o.c. The window wall needs a stud (or added blocking) within ~6 in of y 50 for the beam's end reaction.
FIELD | Ceiling joist nearest 50 3/4 from the bed wall | No longer gates the design (Rev AS: the plate is fixed at 47 1/4-50 3/4 and blocking can be added from the attic), but it decides whether you screw to a joist or block first.
FIELD | Floor joists under the half-wall plate and the kicker
SPECIFY | hw_bottom_plate_a / _b to floor | Left TBD by the user 2026-09-06.
CHECKER | 7 connections carry NO fastener key at all | Filter the Hardware tab for 'NO FASTENER KEY'. verify.py only reports a row that literally says UNSPECIFIED, so these pass silently: beam -> hw_top_plate_2; deck_rim -> hw_top_plate_2; hw_header -> hw_trimmer_a; hw_header -> hw_trimmer_b; hw_top_plate_1 -> hw_header; hw_top_plate_1 -> hw_king_a; hw_top_plate_1 -> hw_king_b. Most are ordinary nailing, but the kicker is already an open anchorage item. Worth making verify.py WARN on a missing key — it would change the 0 WARN baseline, so it is your call. (Counted from the model, not typed: an earlier hand count said 8.)
SPECIFY | kicker anchorage
METHOD | Sheet counts are a real nest, with kerf | Every piece is placed by a guillotine first-fit-decreasing nest that reserves 1/8 on every cut, so the Cut layout tab and materials/cut-layout.svg are a layout you can mark out, not an indicative count — the diagrams draw each piece at its finished size with the kerf as the gap between them, and no two pieces overlap or run off a sheet (asserted at build time). Rotation is allowed and the layout flags which pieces came out turned, so an appearance call can override one. TWO CAVEATS. There is no factory-edge trim allowance: the first piece sits in the corner, so the layout assumes two usable edges — kerf IS reserved against the far edge, which is roughly the 1/8 back. And the deck and the loft ceiling are OVER 48 in y (48 1/4 and 50), so that dimension has to run along the sheet's 8 ft length and each takes one sheet per piece.
METHOD | Cut lengths are FRAMING extents | Finished faces are their own parts. No waste allowance is added anywhere; the board counts include a 1/8 kerf per cut and nothing else.
