galenandrew/wills-loft-bed/cad-out/model.stl

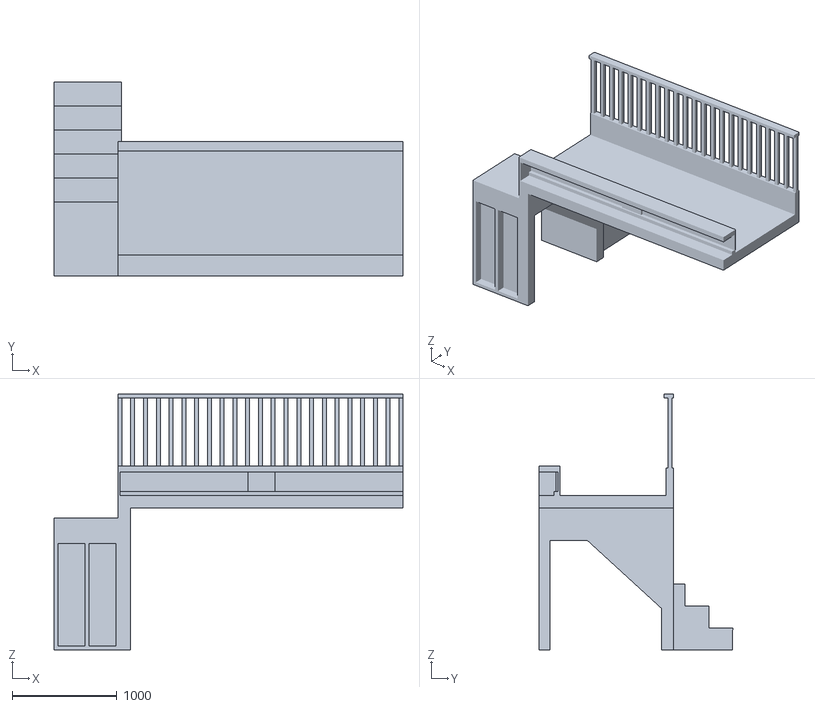
[picture p1: CAD file, 2026-09-07]
cad-out/model.stl
3327.4 x 1851.0 x 2438.4
