galenandrew/wills-loft-bed/dimensions.yaml

# dimensions.yaml — the single source of truth for the loft bed.
#
# Rev U (2026-09-04). Supersedes the Rev T encoding (archive/dimensions-T.yaml).
# `python3 verify.py` recomputes every derived quantity and checks every
# declared connection for real three-axis overlap; `python3 build.py` renders
# site/ from this file. Both run automatically from the edit hook. Fix the data, re-run.
#
# COORDINATES (inches, decimal — verify.py prints nearest 1/16 alongside)
#   x  from the WINDOW wall finished face, toward the right wall (0 … 131)
#   y  from the BED wall finished face, toward the closet wall    (0 … 186)
#   z  above finished floor                                        (0 … 96)
# Every extent is the FRAMING extent of that member (actual lumber size),
# never a finished dimension. Finished faces are separate members (wrap,
# sheathing, ply).
#
# Rev W decisions:
#   · tread/riser joinery corrected. The exposed face of each plumb notch is its
#     DOWNHILL side, so the riser board goes IN FRONT of the cut (y1 → y1+3/4), its
#     bottom edge on the stringer's horizontal cut for the tread below. The tread
#     below starts where that riser ends and butts its face — simple butt joint,
#     riser behind the tread, nothing notched. Rev V's note said the opposite and
#     the drawing drew a third thing (riser recessed INTO the stringer); a CAD
#     kernel check found it (audits/V-kernel-spike.md).
#   · consequence: every board is full 24" width, tread boards stay 9 1/8, and the
#     nosing-to-nosing going is exactly 9.000 at all five steps. Framing lines are
#     unchanged; the FINISHED nosings land 7/8 downhill of them, so the stair's
#     finished projection is 72 7/8 (framing 72) and the landing 27 7/8 (framing 27).
#   · lnd_ply runs to y 27.875 — 3/4 past the framing line for the riser board, then
#     the same 1/8 nose the treads get. Rev V drew that nose as a literal in d4.
#   · the stringers are notched 1 1/2 x 3 1/2 over the kicker at their floor seat.
#
# Rev V decisions:
#   · treads 3/4" plywood, no nosing — 1/8" overhang, tape-sealed edge, painted; stringers dropped 3/4"
#   · landing plywood colored as the finished surface (matches the tread/riser finish)
#
# Rev U decisions (see audits/U-decisions.md):
#   · stringers extend 9" under the landing; plumb cut 41.74→48.75 = a 2x8
#   · landing box all 2x8 on that line; rim on HUC28s; joists run with the stringers
#   · nook opening jambed in 3/4 poplar; finished ceiling 40.75, flush through the opening
#   · CLOSED at Rev AG, not parked: the beam's window end is the 10 1/2 tongue over a
#     3 1/2 notch, bearing 2.62 sq in on side_ledger + 2.62 on deck_joist_tail (3" of
#     backing, not 1"); and slat 0 has a real seat because the beam runs to x 0 now.
#     cad-out/loft.txt carries both areas.
# Anything marked ASSUMED is not in the drawings and must be confirmed.

rev: BD.1
units: inches
room:
  x: 131
  y: 186
  ceiling: 96
  window:
    wall: window
    y:
    - 95
    - 150
  door:
    wall: right
    y:
    - 150
    - 182
    width: 32
    to_corner: 4
    note: 'Rev AB: 4, was 3.5. ASSUMED — not measured. Every placed thing along the right
      wall agreed on 185.5 from the bed wall to the closet corner while room.y said 186, so
      the survey missed by 1/2 and the chain could not close. 4 is the value that closes it
      (186 - the door''s far edge at 182) and it disturbs nothing else, but the 1/2 could
      equally be in room.y or in any item along the wall. FIELD: confirm with a tape, door
      casing to the corner and the room''s overall depth. Nothing in the build depends on
      this — the deepest built member is the stringer foot at y 72 and everything is
      dimensioned outward from the bed wall — so the whole 1/2 lands in the stair-to-dresser
      gap either way.'
mattress:
  size:
  - 38
  - 75
  thickness: 8
  note: 'Rev AI: 8, the mattress alone - the 2 topper is dropped, to buy back the sitting
    headroom it cost (28 -> 30). Rev AG had measured the pair at 10 and sized the beam and
    the boxed ledge off a 68 mattress top; the top is 66 now, so the beam''s finished top at
    68.5 stands 2 1/2 proud instead of 1/2. Was ASSUMED 6 before it was measured at all.'
lumber:
  2x2:
  - 1.5
  - 1.5
  2x4:
  - 1.5
  - 3.5
  2x6:
  - 1.5
  - 5.5
  2x8:
  - 1.5
  - 7.25
  2x10:
  - 1.5
  - 9.25
  2x12:
  - 1.5
  - 11.25
  # NOMINAL 2x14, like every other key here; 1.75 x 14 is the actual, the same way
  # 2x4 is actually 1.5 x 3.5. LVL is sold at the 1-3/4 ply thickness, so 2x is its
  # nominal. Cut lists and member extents use the ACTUAL, always.
  lvl-2x14:
  - 1.75
  - 14
  header-2x10-sandwich:
  - 3.5
  - 9.25
  ply-3/4:
  - 0.75
  - null
  ply-1/2:
  - 0.5
  - null
  # Rev BA: paint-grade SOLID stock at the 2x4 section - 1 1/2 x 3 1/2 actual, the same
  # section as an SPF 2x4, but knot-free and stable enough to paint. Poplar 8/4 S4S is the
  # first choice; clear/select pine at the same section is an acceptable substitute. It
  # exists for screen_top_plate, a STRUCTURAL member that happens to be fully in view.
  # `poplar-3/4` is gone - Rev AZ moved its last two members (hw_end_cap and its foot) to
  # 1/2 ply, and a stock key nothing uses invites someone to think 3/4 poplar is still in
  # the build.
  poplar-2x4:
  - 1.5
  - 3.5
  # Rev BB: the slats' answer to the same question as screen_top_plate, in the same species
  # - same actual section as a framing 2x2, 1 1/2 x 1 1/2. Source 1 1/2 x 1 1/2 S4S poplar
  # or clear/select pine directly if it can be found; otherwise buy the 1 1/2 x 3 1/2 stock
  # (the same board as screen_top_plate) and rip/sand it down.
  poplar-2x2:
  - 1.5
  - 1.5
stair:
  # Rev Y: the riser is an INPUT now, not 58/7. Six equal risers carry the stair to
  # the landing; the seventh (landing → loft deck) is set by the framing stack above
  # the nook header and need not match — see `top_riser`.
  riser: 8.25
  top_riser: 8.5
  risers: 7
  run: 9
  treads: 5
  landing_depth: 27
  width: 24
  stringer_stock: 2x12
  stringer_count: 3
  stringer_pitch: 11.625
  tread_thickness: 0.75
  tread_board_width: 9.125
  throat_min: 3.5
  top_run: 9
  landing_deck_thickness: 0.75
nook:
  opening_y:
  - 3.5
  - 46.5
  header_bottom: 41.5
  flat_ceiling_to_y: 18.26
  soffit_panel_thickness: 0.5
  light: 6-inch recessed — fixture depth not stated; chase is ~4 inches
  note: 'Rev X: header_bottom is now the landing-ledger bottom (lnd_ledger_bedwall.z[0]),
    so the soffit runs flush from under the landing out through the opening. Rev U''s poplar
    jambs are gone; the nook is one ply-wrapped tube from x 102.75 to the right wall (x 131).
    Rev AD: the tube starts 3/4 back from the half-wall''s outer face, not on it — the face is
    its own panel and laps the tube''s end. Rev AZ: the `wrap:` KEY IS GONE. It was one number
    doing two jobs — it set the finished flat-ceiling face (header_bottom − wrap) and, via
    drawings JAMB_Y, the finished opening — and the two are no longer one number: the ceiling
    panel is 1/2, the bed-wall lining is still 3/4 and the short-wall lining is 1/2. The
    ceiling face now comes off soffit_panel_thickness, which is what that arithmetic always
    meant, and JAMB_Y is read straight off the two lining members'' own faces. Both were
    identical at 3/4 and would have quietly produced a wrong opening here.'
loft_lighting:
  desk:
    fixture: 4-inch slim canless LED
    count: 2
    x: 12
    y:
    - 12.5
    - 37.5
  walkway:
    fixture: 6-inch slim canless LED
    count: 1
    x: 63
    y: 25
  note: 'Three lights recessed into loft_ceiling, same shallow-cavity problem as the
    nook light: loft_light_chase is only the joist depth (3.5, ceiling top to deck ply).
    Slim canless fixtures, which can intersect a joist (unlike a can housing), so
    positions are true geometric centres, not joist-bay centres. The two 4in over the
    desk share ONE x, 12 - the centre of the desk''s own depth (x 0-24) - and run along y
    instead, parallel to the window wall and the desk''s long axis: y 12.5 and 37.5, the
    quarter points of loft_ceiling''s 0-50 run. The 6in walkway light sits at the true
    midpoint, x 63, between the desk''s inner edge (x 24) and the half-wall''s loft face
    (x 102, clear_below_deck_x) - which happens to fall on deck_joist[5] (61.5-63); fine
    for a slim canless fixture, and CONFIRMED by the builder (2026-09-09): low-profile
    canless wafers, 1/2 clearance in the 3.5 chase, so all three sit clear of the joists
    they cross. Position and switch location as encoded above.'
electrical:
  note: 'Rev BC. The devices the room needs, placed on the members they mount to.
    loft_lighting (above) stays where it is because Drawing 1 of the Rev U set reads
    it; everything else lives here, and the drawings read both through one adapter
    (verify.electrical_devices) so no position is written down twice. `face` is the
    direction the device LOOKS; `box` is [width, height, depth] with depth going
    into the wall behind that face, and `lets_into` names every member the box is
    cut into. verify.py checks each device sits on its host, that a `centred` one
    really is centred, and that its box hits nothing it has not declared.'
  devices:
  - id: nk_light
    label: nook light
    kind: light
    circuit: nook
    fixture: 6-inch canless LED wafer
    host: nk_soffit_flat
    face: -z
    at:
    - 116.875
    - 11.25
    - 41.0
    centred: true
    box:
    - 6.5
    - 6.5
    - 1.0
    lets_into: []
    note: 'CONFIRMED by the builder (2026-09-08): the centre of the flat nook ceiling.
      The chase above the panel is nook_light_chase 3 3/4, from the panel top at 41 1/2
      to the landing joists at 45 1/4, so the wafer (~5/8) and its driver both sit
      clear of lnd_joist[0], whose x 114 3/4-116 1/4 otherwise runs straight over
      this point. Canless, not a can: nothing 4 inches deep fits here. Power must be
      run before the soffit panel goes up.'
  - id: ledge_outlet_window
    label: outlet
    kind: outlet
    circuit: ledge_outlets
    fixture: flush duplex receptacle in the lid
    host: ledge_lid
    face: +z
    at:
    - 8.0
    - 4.0
    - 69.0
    box:
    - 2.0
    - 3.0
    - 2.5
    lets_into: []
    note: 'Window end. Centred across the lid''s 8 width, so the box hangs into the
      ledge well clear of ledge_cleat (y 0-1 1/2) and ledge_cleat_rail (y 5 3/4-7 1/4),
      and clear of every ledge_strut in x. Faces up because there is nowhere else:
      the front rail''s face is behind the mattress below 66 and only 2 1/4 tall above it.'
  - id: ledge_outlet_stair
    label: outlet
    kind: outlet
    circuit: ledge_outlets
    fixture: flush duplex receptacle in the lid
    host: ledge_lid
    face: +z
    at:
    - 99.0
    - 4.0
    - 69.0
    box:
    - 2.0
    - 3.0
    - 2.5
    lets_into: []
    note: Stair end. Same detail as the window end.
  - id: sw_half_wall
    label: 2 switches
    kind: switch
    circuit: null
    switches:
    - nook
    - under_loft
    fixture: single-gang shallow box, two-circuit stacked rocker
    host: hw_sheath_loft_head
    face: -x
    at:
    - 102.25
    - 44.0
    - 36.0
    box:
    - 2.0
    - 3.0
    - 1.5
    lets_into: []
    note: 'TWO SWITCHES, ONE BOX, in the cavity — no framing is cut. At reach height
      the half wall is a portal frame, so the first reading of it was that the only
      solid face was the 4-wide board over the far jamb pack, which would have meant
      letting the box into the trimmer, the flitch and the king. That was wrong: the
      nook opening''s head RAKES, following the stringers down from 41 at y 18 1/4 to
      15 1/2 at y 46, and hw_sheath_loft_head is the panel above that line. At z 39 1/2
      the face is therefore continuous board from about y 20 all the way to the wall''s
      end, and behind it — above the rake nailer, below the header — is open cavity.
      The box sits at y 44: 2 wide, so y 43-45, with 1 1/2 clear of hw_trimmer_b at
      46 1/2 and the nailer''s 1 1/2 band 18-20 1/4, nowhere near it. Shallow single-gang
      old-work box clamped to the 1/2 face; a scrap 2x4 backing block behind it is the
      builder''s option, and has to go in before the face is sheathed either way.
      A 2-gang plate is 4 5/8 wide and the two switches are still a stacked rocker in
      one gang, which is what suits a single-gang box. 36 AFF, so the top of the box is
      37 1/2 and the header bottom at 41 1/2 is 4 clear above it — room for the cable to
      come in and be clamped, which 39 1/2 did not really leave. The cavity behind runs
      from the rake nailer at about 20 up to the header, so the height is a choice, not
      a constraint: 36 is low for an adult and a standard child-accessible height.'
screen:
  slat_count: 23
  slat_size: 1.5
  extent_x:
  - 0
  - 107
  slat_bottom: 68.25
  slat_top: 94.5
  max_clear: 3.5
members:
- id: rear_ledger
  stock: 2x4
  x:
  - 1.5
  - 106.25
  y:
  - 0
  - 1.5
  z:
  - 53.75
  - 57.25
  role: structural
  note: 'Rev T says 107 long and draws it 0-107, but the side ledger occupies x 0-1.5 and the
    half-wall''s stair face - hw_sheath_stair, which still covers 106.25-107 at this height -
    takes the other end. Cut length is therefore 104.75. CUT-LIST CORRECTION.

    Rev AO: a 2x4 at deck level, not a 2x6 standing 2 proud of it. Top is now the joist top
    (57.25), matching side_ledger, so deck_ply runs over it to the bed wall instead of
    butting its face - see deck_ply. This also removes the need for ledger_blocking, which
    existed only to give the ply edge a bearing shelf between joists while the ledger stood
    taller than the deck; with the ledger and joists now the same depth that shelf is
    continuous along the whole run.'
- id: side_ledger
  stock: 2x4
  x:
  - 0
  - 1.5
  y:
  - 0
  - 50
  z:
  - 53.75
  - 57.25
  role: structural
  note: 'Rev AG: a 2x4 at DECK level, not a 2x10 standing to the beam top. Its top is the
    joist top (57.25), so deck_ply runs over it to the window wall, the boxed ledge needs no
    notch, and nothing of the ledger shows above the deck. It stays 50 out (Rev Z) so it
    reaches under the beam''s full 1 3/4 width. The beam no longer butts its end face: the
    beam is NOTCHED over it and BEARS on its top, together with deck_joist[0] sistered to
    its inboard face - 3 (x) x 1 3/4 (y) = 5.25 sq in, about 115 psi against 425 allowable.
    FIELD, now load-bearing: the reaction lands 1.5-3 off the wall face and the overturning
    couple works over 3.5 of ledger depth instead of 9.25, so there must be a stud (or
    blocking added) within 6 of y 50, and the deck ply must be glued and screwed to the
    ledger top - that diaphragm is what stops a shallow ledger rolling.'
- id: deck_joist
  stock: 2x4
  x:
  - 1.5
  - 3
  y:
  - 1.5
  - 48.25
  z:
  - 53.75
  - 57.25
  role: structural
  repeat:
    count: 9
    axis: x
    pitch: 12
  note: 'Rev AG: 48.25 out, not 47 - the beam is 1 3/4 thick now and its outer face had to
    stay on 50, so the joists grew 1 1/4 to reach it. Span 46 3/4; deflection under 50 psf
    is 0.035, L/1350.'
- id: deck_joist_tail
  stock: 2x4
  part_of: deck_joist[0]
  x:
  - 1.5
  - 3
  y:
  - 48.25
  - 50
  z:
  - 53.75
  - 57.25
  role: structural
  note: 'Rev AG: NOT a separate piece - the last 1 3/4 of deck_joist[0], which runs 48 1/2
    to y 50 while the other eight stop at the beam face. Sistered to side_ledger over its
    whole length, it is what widens the beam''s seat from the ledger''s 1 1/2 to 3. Cut list:
    deck_joist[0] is one 48 1/2 2x4, the rest are 46 3/4.'
- id: deck_rim
  stock: 2x4
  x:
  - 104.75
  - 106.25
  y:
  - 1.5
  - 48.25
  z:
  - 53.75
  - 57.25
  role: structural
- id: deck_blocking
  stock: 2x4
  x:
  - 3
  - 13.5
  y:
  - 46.75
  - 48.25
  z:
  - 53.75
  - 57.25
  repeat:
    count: 8
    axis: x
    pitch: 12
  role: structural
  note: 'Rev AU: NEW. On edge between the joist ends at the beam''s face, filling all eight
    10 1/2 gaps (x 3-13 1/2, then every 12). The joists HANG off the beam on LUS24s, so
    without these the deck ply''s front edge lands at the LVL with nothing under it and
    nothing fastening it - the deck is the anti-roll diaphragm that stands in for posts, and
    it was glued and screwed to both ledgers and connected to the beam at zero points. These
    give the edge a continuous nailer into the LVL and close the diaphragm. Full joist depth
    (3 1/2) so a screw down through the ply catches 1 1/2 of solid edge, and 1 1/2 thick in y
    so it reaches back from the beam face into the bay. One 8 ft board covers all nine
    blocks. NOW OR NEVER: they go in before the deck ply.'
- id: deck_blocking_end
  stock: 2x4
  x:
  - 99
  - 104.75
  y:
  - 46.75
  - 48.25
  z:
  - 53.75
  - 57.25
  role: structural
  note: 'Rev AU: the ninth block. The last bay is not 10 1/2 - it runs from joist 8 (x 97 1/2
    to 99) to deck_rim at 104 3/4, so it is 5 3/4 and cannot ride the repeat. It is the bay
    over the half wall, where the beam is notched down onto hw_top_plate_2, so it is the last
    one to leave open. x 0 to 1 1/2 needs nothing: side_ledger runs the full y 0 to 50 and
    already backs the ply edge there.'
- id: deck_seam_blocking
  stock: 2x4
  x:
  - 3
  - 13.5
  y:
  - 22.25
  - 25.75
  z:
  - 55.75
  - 57.25
  repeat:
    count: 5
    axis: x
    pitch: 12
  role: structural
  note: 'Rev AX: FIVE blocks. The deck''s cross-joist seam stops at x 62 1/4, joist 5''s centre,
    where the layout changes to one full-depth 44 x 48 1/4 panel over the landing end - moved
    one joist further in than Rev AW''s 74 1/4 so the seam sits 14 3/4 inside the mattress edge
    at x 77 instead of 2 3/4. 62 1/4 is as far as it can go: the next joist in would need a 56
    wide panel, and 48 1/4 already has to run along the sheet''s 96, so 48 is the hard limit on
    its width. The blocked run is x 3 to 61 1/2; everything beyond is either the joist the seam
    lands on or the unseamed panel. Rev AV: FLAT (3 1/2 in y, 1 1/2 deep) under the deck
    ply''s seam at y 24,
    which gives 1 3/4 of bearing to each panel edge - the beam-face blocking is on edge
    because it backs one edge and wants depth for screws; this backs two and wants width.
    The seam exists to save a sheet: the deck is 48 1/4 in y, over a sheet''s 48 width, so
    without a seam each piece takes its own sheet. Exact piece sizes and sheet counts live in
    tools/materials.py PANEL_SPLITS, not here - this note used to quote a superseded count.
    The seam runs ACROSS the joists, not along one - it cannot land on a joist centre, which
    is why it needs blocking; it is caught where it crosses each joist and unsupported over
    the 10 1/2 between. y 24 puts it under the mattress (y 8 3/4 to 46 3/4), so it is never
    seen. x 0 to 1 1/2 needs none: side_ledger runs the full y 0 to 50 and backs it there.'
- id: deck_ply
  stock: ply-3/4
  x:
  - 0
  - 106.25
  y:
  - 0
  - 48.25
  z:
  - 57.25
  - 58
  role: sheet
  note: 'Rev AG: 106 1/4 x 46 3/4, was 104 3/4 x 45 1/2. It runs over the side ledger to the
    window wall now that the ledger is at deck level, and out to the beam''s new face at
    48.25. Glue and screw it to the ledger top at 6 o.c. - see side_ledger.

    Rev AO: now 48.25 x 48.25, flush to the bed wall - rear_ledger dropped to deck level
    (see rear_ledger) so the ply runs over its top too, the same way it already ran over
    side_ledger. This is what let ledger_blocking go: the ply''s wall-side edge now bears on
    the ledger continuously instead of on blocking pieces between joists.'
- id: beam
  stock: lvl-2x14
  x:
  - 3
  - 106.25
  y:
  - 48.25
  - 50
  z:
  - 53.75
  - 67.75
  role: structural
  note: 'Rev AG: a SINGLE 1 3/4 x 14 LVL, not a doubled 2x10. Depth is set by the mattress,
    not by load - top at 67.75 framing, 68.5 with the cap, half an inch proud of a 10
    mattress, so the beam is the bed rail. Bending is nowhere near it: worst case about
    21,000 in-lb against S = 57.2 in3 = 367 psi, and midspan deflection 0.015.
    Its outer face stays on 50 - beam_wrap_face, the slats, the screen plate and the
    half-wall''s 50-deep top plate all key off it - so the 1 1/4 it lost in width was given
    to the joists, not taken off the platform. At the half-wall end 1 1/2 of its 1 3/4 lands
    directly over hw_king_b (y 48.5 to 50), a straight post to the floor. This row is the
    body; beam_tongue is what survives the notch at the window end. Cut list: ONE LVL
    106 1/4 long, notched 3 (x) x 3 1/2 (z) out of the bottom left corner.'
- id: beam_tongue
  stock: lvl-2x14
  part_of: beam
  x:
  - 0
  - 3
  y:
  - 48.25
  - 50
  z:
  - 57.25
  - 67.75
  role: structural
  note: 'Rev AG: NOT a separate piece - the 10 1/2 of beam left above the notch, bearing on
    side_ledger and deck_joist_tail at 57.25 and running to the window wall. The notch is
    3 1/2 deep on a 14 beam: exactly the d/4 the code allows for a sawn end notch, and the
    NDS notch-shear formula gives about 1,960 lb against a reaction near 600. LVL makers
    formally prohibit bottom notches - a condition of their published capacities, which assume
    an intact tension edge, not a strength finding about this beam: 14 is set by the mattress
    top, so the section is roughly 7x over-strength in bending (370 psi vs 2600) and the notch
    check has 3x margin. Rev AT: the reinforcement is beam_wrap_face, NOT a separate cheek.
    Rev AG had prescribed a 3/4 ply cheek on the INBOARD face running 24 past the shoulder,
    which cannot be built there - deck_ply fills y to 48.25 at z 57.25-58 straight across the
    corner, and deck_joist[1] and [2] run out to 48.25 within that 24. The outboard face is
    clear and already carries 3/4 ply from z 53 to the beam top over the full length, and it
    lands on exactly the right members: above 57.25 it screws into the tongue, below it into
    the y-50 end faces of side_ledger and deck_joist_tail, the two members the tongue bears
    on. That is a better splice than an inboard cheek, in the same plane as any split the
    corner could start, and it costs a fastener schedule rather than a part. loft_ceiling is
    the SECOND restraint and it was nearly missed: it is screwed to the bottom edge of the very
    piece a split would separate (the beam''s bottom 3 1/2 beyond x 3, whose underside is the
    z 53.75 line) and to side_ledger and deck_joist_tail on the other side of x 3, so it ties
    that piece to members that cannot move, in the direction it would drop. Secondary to the
    wrap - withdrawal from a 1 3/4 laminated edge rather than shear in the plane of the split -
    but real, and between the two the notch is covered from both faces it can move relative to. A metal strap was
    considered and is not needed: it would do the same job in the same plane as screws that
    are going in anyway. It also gives slat[0] a real seat -
    the beam runs to x 0 now, so slat 0 is no longer a special case.'
- id: beam_wrap_face
  stock: ply-1/2
  x:
  - 0
  - 107
  y:
  - 50
  - 50.5
  z:
  - 53.25
  - 67.75
  role: finish
  note: 'Rev AG: 14 3/4 tall, was 10. Its top is the LVL''s top; beam_wrap_top laps over it,
    so no end grain shows on the top edge. Rev AQ: SPECIFY resolved - paint-grade ply, not
    poplar. At 107 long no poplar board is that size anyway, and it is the most-seen face
    on the bed and it is painted, so ply was always the likely answer; 107 still exceeds one
    4x8 sheet, so it is at least two pieces with a filled, sanded vertical butt joint - the
    corner at beam_end_cap (x 106.25-107) is a butt/lap, not a miter, matching how that member
    already dies into this one. Rev AZ: 1/2 ply, not 3/4. Its finished face comes in to 50.5
    and its bottom edge rises to 53.25 to meet the thinner loft_ceiling, so it is 14 1/2 tall,
    was 14 3/4. THE NOTCH SPLICE IS UNCHANGED IN KIND but thinner: it still straddles the
    re-entrant corner in the plane of any split and works in shear, and its screws now take
    1 1/2 of embedment in the LVL instead of 1 1/4 - see the connection rows, which were
    re-stated for the thinner panel rather than left to drift.'
- id: beam_wrap_inner
  stock: ply-1/2
  x:
  - 0
  - 106.25
  y:
  - 47.75
  - 48.25
  z:
  - 58
  - 67.75
  role: finish
  note: 'Rev AG: NEW. The bed side of the beam is 9 3/4 of bare LVL above the deck now, so it
    is wrapped to match the face. It sits ON the deck ply and butts its edge - the ply runs
    to the rough beam at 48.25 - which puts the finished bay at 8 to 47.75 = 39 3/4 for a 38
    mattress. Rev AQ: ply, following beam_wrap_face. Rev AZ: 1/2 ply, following it again; the
    bay gains the 1/4 the panel gave up, so the slack is 1 3/4 (was 1 1/2, and 1 in Rev T).'
- id: beam_wrap_top
  stock: ply-1/2
  x:
  - 0
  - 107
  y:
  - 47.75
  - 50.5
  z:
  - 67.75
  - 68.25
  role: finish
  note: 'Rev AG: NEW. A cap over the LVL and both wrap faces, lapping their top edges.
    The slats stand on it and screw through it into the LVL, which is the first time that
    fastener has been real rather than UNSPECIFIED. Rev AQ: ply, following beam_wrap_face.
    Rev AZ: 1/2 ply, following it again - 2 3/4 wide now (was 3 1/4), because both wrap faces
    came in 1/4, and its top drops from 68.5 to 68.25. That top is the slats'' seat, so every
    slat gets 1/4 LONGER to keep screen.slat_top at 94.5.'
- id: loft_ceiling
  stock: ply-1/2
  x:
  - 0
  - 102.25
  y:
  - 0
  - 50
  z:
  - 53.25
  - 53.75
  role: finish
  note: 'Rev AP: NEW. A finished ceiling under the whole loft platform, from the bed wall to
    beam_wrap_face, closing the joist bays that were bare framing. This is what
    beam_wrap_underside used to do for the 3 under the beam alone before Rev AG deleted it
    ("no reason anyone could point to" for the beam to have less clearance than the joists,
    see revisions.json) — generalised to the full width rather than a narrow strip.
    Stops at the half-wall''s loft face (hw_sheath_loft_a''s near face), same line the
    deleted member used; the half-wall''s own framing and hw_end_cap close the rest. Screwed
    up from below into rear_ledger, side_ledger, deck_joist and beam bottoms, all flush at
    53.75 (see clear_under_joists / clear_under_beam, finished instead of bare
    framing). SPECIFY: it fits no single sheet good in either dimension, so this is at
    least two pieces with a seam — land it on a joist bay line for backing; the builder''s
    call, same as beam_wrap_face. Rev AZ: 1/2 ply, not 3/4. Two consequences, both small and
    both in the right direction: the finished ceiling drops 1/4 to 53 1/4, so headroom under
    the loft GAINS 1/4; and the panel LENGTHENS 1/4 to 102 1/4, because the half-wall''s loft
    sheathing went to 1/2 with it and its face moved in. It is the largest painted panel in
    the build and the one whose weight is held overhead by screws in withdrawal, so it is the
    single best place the thinner stock pays for itself. It is still the SECOND notch restraint
    (see beam_tongue): that claim is about where it is screwed, not how thick it is.'
- id: ledge_front_rail
  stock: ply-3/4
  x:
  - 0
  - 106.25
  y:
  - 7.25
  - 8
  z:
  - 58
  - 68.25
  role: finish
  note: 'Rev AS: 3/4 PAINT-GRADE PLY, ripped, not 1x12 poplar - and it is TWO pieces with a
    butt joint at x 53 1/8, the exact centre of ledge_strut[1] (52 3/8 to 53 7/8), backed by
    ledge_rail_splice. 106 1/4 exceeds any sheet, and this face is painted, so ply rips with a
    splice beat a long poplar board that would have needed a joint anyway. Rev AI: rips to 10 1/4 (Rev AG had 11 1/4 over a 10 mattress; Rev T had 7 1/4). The
    notch is GONE. The side ledger is a 2x4
    at deck level now, so nothing stands in the rail''s way at the window end: it is one
    plain 106 1/4 board standing on the deck ply from x 0. Rev AB''s notch and its tongue row
    are deleted. 10 1/4 puts the lid 3 proud of the 66 mattress top - and it is a rip from
    1x12 poplar with margin to spare, where 11 1/4 was the whole board.'
- id: ledge_cleat
  stock: 2x2
  x:
  - 0
  - 106.25
  y:
  - 0
  - 1.5
  z:
  - 66.75
  - 68.25
  role: structural
  note: 'Rev AJ: NEW. The lid had a bearing edge at the front - the top of ledge_front_rail -
    and nothing at all along the bed wall: an 8 deep board supported on one edge. This is a
    2x4 ON EDGE against the wall, 1 1/2 proud and 3 1/2 tall, its top on 68.25 = the lid''s
    underside. On edge, not flat, so its face is flush with rear_ledger''s at y 1.5 and the
    well stays 5 3/4 wide; flat it would have eaten 2 more. It is also what the three
    ledge_strut pieces die into. Cut list: 106 1/4 - one 10 ft 2x4, or two pieces butted over
    a stud.

    Rev AO: dropped to a 2x2 - 1 1/2 tall instead of 3 1/2, bottom now 66.75, same range as
    ledge_strut. Top stays 68.25 (the lid''s underside) and the 1 1/2 proud-of-wall face is
    unchanged, so nothing else here moves: the strut tenons into the same face, the wall
    fastener still lands in the same 1 1/2 of thickness, and the well is still 5 3/4 wide.'
- id: ledge_cleat_rail
  stock: 2x2
  x:
  - 0
  - 106.25
  y:
  - 5.75
  - 7.25
  z:
  - 58
  - 59.5
  role: structural
  note: 'Rev AL: ON THE DECK PLY, giving the front rail''s BOTTOM edge something to fasten to.
    Rev AK had it at the top of the rail as the lid''s front bearing, which was wrong: it was
    fixed to the rail and to nothing else, so the whole front of the box hung off the lid.
    The lid''s front edge fastens straight to the rail''s top edge instead, and the rail is
    now held at both ends - cleat at the bottom, lid at the top.
    2x2, not the 2x4 the bed-wall cleat is: a screw has to go DOWN through this one into the
    joists, and 1 1/2 + 3/4 of ply lets a 3-1/2 bury 1 1/4 in a joist, where 3 1/2 of 2x4 on
    edge would need a 6. 1 1/2 is ample to screw a 3/4 rail to. It takes 1 1/2 off the well
    floor and 1 1/2 of its height; the well is still the full 5 3/4 above 59.5.'
- id: ledge_strut
  stock: 2x2
  x:
  - 0
  - 1.5
  y:
  - 1.5
  - 7.25
  z:
  - 66.75
  - 68.25
  role: structural
  repeat:
    count: 3
    axis: x
    pitch: 52.375
  note: 'Rev AM: three 5 3/4 struts under the lid, square to ledge_cleat, spanning the well
    from the cleat''s face to the back of ledge_front_rail. They FIX THE GAP: the rail is a
    3/4 board cleated only at its foot, and without them nothing holds its top on 7.25, so the
    lid-to-rail joint would open or close along its length. They also back that joint - the
    lid lands 1 1/2 x 5 3/4 on each strut instead of bridging bare air between its two long
    edges. The 52.375 pitch is not arbitrary: it puts strut 0 flush with the window wall,
    strut 2 flush with the ledge''s stair end at 106.25, and strut 1 exactly on the midpoint
    (its centre is x 53.125). Three identical 2x2s, 5 3/4 each.'
- id: ledge_rail_splice
  stock: ply-3/4
  x:
  - 48.125
  - 58.125
  y:
  - 6.5
  - 7.25
  z:
  - 59.5
  - 66.75
  role: structural
  note: 'Rev AS: NEW. The backer behind ledge_front_rail''s butt joint at x 53 1/8, glued and
    screwed to both rail pieces from inside the well. 10 x 7 1/4 of 3/4 ply, cut from the rail''s
    own offcut. It fits the one clear gap in the well''s back: ledge_cleat_rail stops at z 59 1/2
    and ledge_strut[1] starts at 66 3/4, so 59 1/2 to 66 3/4 at y 6 1/2-7 1/4 is empty. The rail
    is the only ledge board whose joint has nothing behind it at mid-height - the lid has the
    cleat and the rail top under both ends of its joint line, so it gets no splice.'
- id: ledge_lid
  stock: ply-3/4
  x:
  - 0
  - 107
  y:
  - 0
  - 8
  z:
  - 68.25
  - 69
  role: finish
  note: 'Rev AS: 3/4 PAINT-GRADE PLY, ripped, not poplar, and TWO pieces - 53 1/8 + 53 7/8
    with the butt joint at x 53 1/8 over ledge_strut[1]. It needs no splice plate: the lid is
    supported continuously on BOTH long edges, by ledge_cleat at y 0-1 1/2 and by the rail''s
    top edge at y 7 1/4-8, so the joint line is held at both of its ends. Rev AM: NOT hinged - decided, and Rev F''s optional hinges are off the table. It is
    one continuous board screwed down onto the cleat, the three struts and the rail. NOTE the
    consequence: the well is a closed void now, about 3.5 cu ft of it. If that storage is
    wanted, the lid has to be screwed and filled rather than glued, or the box opened from an
    end. Rev AI: top at 69,
    3 proud of the 66 mattress top, on a 10 1/4 rail. The well is 5 3/4 x 10 1/4, about
    3.5 cu ft. Rev AH: it runs the FULL 107, wall to finished face - the butt with
    ledge_end_cap is reversed, so the lid laps the skirt''s top edge instead of dying into
    its face. Bears on that edge over 3/4 x 8. One ply edge fewer to fill, and the joint at
    the stair end is now a ply-to-ply line in the same plane as the front rail''s. (Rev BA:
    said poplar-to-poplar, left over from before Rev AS made both boards paint-grade ply.)'
- id: ledge_end_cap
  stock: ply-3/4
  x:
  - 106.25
  - 107
  y:
  - 0
  - 8
  z:
  - 58
  - 68.25
  role: finish
  note: 'Rev AD: still the boxed ledge''s end, but no longer a separate part - it is the top of
    the stair face (Rev AE: of hw_sheath_stair, the one skirt board), so the stock is 3/4 ply,
    not 3/4 poplar, and the joint that used to run across at z 58 is gone. Rev AH: it stops 3/4
    below the lid''s top - 68.25 since Rev AI - and ledge_lid runs out over its top edge to 107 - so the only ply edge
    left showing here is the one that meets the front rail; band or fill that one.'
- id: hw_bottom_plate_a
  stock: 2x4
  x:
  - 102.75
  - 131
  y:
  - 0
  - 3.5
  z:
  - 0
  - 1.5
  role: structural
  note: 'Rev AE: ONE plate, 28 1/4 long — the half-wall''s bed-wall-side plate and the nook''s
    bed-wall nailer plate (was nk_bedwall_plate, x 107→131) are the same board now that the
    3/4 sheathing that used to separate them at 106.25→107 is gone. Carries hw_king_a,
    hw_jamb_ply_a and hw_trimmer_a over its first 3.5, then the three nook studs. Rev Z: 3.5
    wide, not 3 — the jamb pack it carries gained a 1/2 ply flitch. It still does not run the
    full 50 in y: the opening (y 3.5→46.5) is open to the floor so you can walk into the nook.'
- id: hw_bottom_plate_b
  stock: 2x4
  x:
  - 102.75
  - 131
  y:
  - 46.5
  - 50
  z:
  - 0
  - 1.5
  role: structural
  note: 'Rev AE: ONE plate with what was nk_shortwall_plate (x 107→131), for the same reason
    as hw_bottom_plate_a. Carries hw_trimmer_b, hw_jamb_ply_b and hw_king_b over its first
    3.5, then the three nook struts — which now sit under stringers A, B and C at 106.25,
    117 7/8 and 129.5. Rev Z: 3.5 wide, not 3.'
- id: hw_king_a
  stock: 2x4
  x:
  - 102.75
  - 106.25
  y:
  - 0
  - 1.5
  z:
  - 1.5
  - 50.75
  role: structural
- id: hw_jamb_ply_a
  stock: ply-1/2
  x:
  - 102.75
  - 106.25
  y:
  - 1.5
  - 2
  z:
  - 1.5
  - 41.5
  role: structural
  note: 'Rev Z: the flitch that makes the jamb pack a full 3.5 deep — 1.5 king + 1/2 ply + 1.5
    trimmer, the same lay-up as header-2x10-sandwich. It exists so the nook side walls can be
    ordinary 2x4 studs on edge with their faces flush to the trimmer faces; at the old 3 pack
    a 3.5 stud stood 1/2 proud of the reveal and broke the one-plane wrap. Glued and nailed
    inside the pack, so it is captured and the trimmer — not the ply — gives the wrap its
    nailing face. Stops at the header bottom: above 41.5 the header fills this band.'
- id: hw_trimmer_a
  stock: 2x4
  x:
  - 102.75
  - 106.25
  y:
  - 2
  - 3.5
  z:
  - 1.5
  - 41.5
  role: structural
  note: 'Rev Z: pushed out 1/2 by the flitch behind it. Its face at 3.5 is the opening reveal
    and the plane the nook bed-wall studs land on.'
- id: hw_trimmer_b
  stock: 2x4
  x:
  - 102.75
  - 106.25
  y:
  - 46.5
  - 48
  z:
  - 1.5
  - 41.5
  role: structural
  note: 'Rev Z: pushed in 1/2 by the flitch behind it. Its face at 46.5 is the reveal on the
    far side, and hw_rake_nailer still dies into it.'
- id: hw_jamb_ply_b
  stock: ply-1/2
  x:
  - 102.75
  - 106.25
  y:
  - 48
  - 48.5
  z:
  - 1.5
  - 41.5
  role: structural
  note: 'Rev Z: the far jamb''s flitch — see hw_jamb_ply_a.'
- id: hw_king_b
  stock: 2x4
  x:
  - 102.75
  - 106.25
  y:
  - 48.5
  - 50
  z:
  - 1.5
  - 50.75
  role: structural
- id: hw_header
  stock: header-2x10-sandwich
  x:
  - 102.75
  - 106.25
  y:
  - 1.5
  - 48.5
  z:
  - 41.5
  - 50.75
  role: structural
  note: 'Rev Y: full 9-1/4 stock again, no rip. Its bottom is the landing-ledger bottom
    (41.5), so the nook soffit is one plane; its top is still on the plates at 50.75. That
    closes only because the riser is 8.25 with a 8.5 top riser — the stack from the ledger
    bottom up to the deck is a fixed 16.5, so the landing-to-deck rise is 8.5 whatever the
    stair riser is. Hanger zone 41.5→48.75 is a true 2x8, so HUC28/LUS24 are unchanged.'
- id: hw_top_plate_1
  stock: 2x4
  x:
  - 102.75
  - 106.25
  y:
  - 0
  - 50
  z:
  - 50.75
  - 52.25
  role: structural
- id: hw_top_plate_2
  stock: 2x4
  x:
  - 102.75
  - 106.25
  y:
  - 0
  - 50
  z:
  - 52.25
  - 53.75
  role: structural
- id: hw_end_cap
  stock: ply-1/2
  x:
  - 102.25
  - 107
  y:
  - 50
  - 50.5
  z:
  - 24
  - 53.25
  role: finish
  note: 'ASSUMED - Rev T never says what closes the wall''s end at y 50 below the wrap.
    Rev AE: one board with hw_end_cap_foot, notched. Stringer A runs past the wall''s end
    at 106.25-107.75 with its skin outboard of it, so below the stringer''s top edge - z 24 at
    this y, tread 3''s cut - the cap can only be 3 1/2 wide; above it, it returns the wall''s
    full finished thickness. Rev AZ: 1/2 PAINT-GRADE PLY, not 3/4 poplar - it is a painted
    return between two painted ply faces, so poplar was buying nothing, and it now nests with
    the rest of the 1/2 stock instead of being the only reason to buy a board. Three numbers
    move with it: it is 4 3/4 wide, not 5, because the wall''s loft face went to 1/2; its top
    goes to 53.25 to meet the raised bottom edge of beam_wrap_face; and its face at 50.5 is the
    beam''s new finished plane, which is also where the treads step (drawings STEP_Y reads this
    row). Cut it as one 4 3/4 x 53 1/4 board with a 1 1/4 x 24 corner taken out, and let the
    skin butt the cut edge at 105.75.'
- id: hw_end_cap_foot
  stock: ply-1/2
  x:
  - 102.25
  - 105.75
  y:
  - 50
  - 50.5
  z:
  - 0
  - 24
  role: finish
  note: 'Rev AE: not a separate part - the narrow lower half of hw_end_cap, beside stringer A.
    Rev AZ: still exactly 3 1/2 wide - both of its edges moved in 1/4 together, the wall''s loft
    face and the skin''s outer face.'
- id: hw_sheath_loft_a
  stock: ply-1/2
  x:
  - 102.25
  - 102.75
  y:
  - 0
  - 4.25
  z:
  - 0
  - 53.75
  role: sheet
  note: 'Rev AD: the nook face is TWO pieces, not three, and the wrap no longer shows on it.
    This is the narrow one — a full-height stile in the bed-wall corner, 4 1/4 x 53 3/4. It
    now runs past the reveal (3.5) to the finished jamb line (4.25), lapping the end of
    nk_wrap_bedwall, which stops at 102.75 behind it. Rev AZ: 1/2 ply - the piece is the same
    4 1/4 x 53 3/4, but the whole loft face of the wall moved in to 102.25 with it. Piece 2 is hw_sheath_loft_head +
    hw_sheath_loft_b, one board. The seam between them is on y 4.25 — the same line as the
    opening jamb below it — so it reads as that line carried up, and it is backed by the wrap
    end below 41.5 and by the header above. One seam, not three, is what the 4x8 sheet costs:
    the whole face is 50 x 53 3/4 and neither dimension fits a 48 sheet. (Rev AE: the STAIR
    face is one piece now — see hw_sheath_stair.)'
- id: hw_sheath_loft_head
  stock: ply-1/2
  x:
  - 102.25
  - 102.75
  y:
  - 4.25
  - 46
  z:
  - 15.57
  - 53.75
  role: sheet
  kind: raked
  rake:
    profile: soffit
    side: above
  note: 'Rev X: the opening head is raked, not square. Rev AD: this row and hw_sheath_loft_b
    are ONE board — the big piece of the two-piece face, 45 3/4 x 53 3/4, cut from a 4x8 with
    the opening sawn out of it. Its edges moved in to the FINISHED jamb lines (y 4.25/45.75)
    and the offset came off the rake, so its bottom edge is now the soffit FACE (40.75 flat,
    then the stringer undersides less the panel) instead of the framing line 3/4 above it.
    That is what lets the one panel cover the ends of all three lining sheets: nk_wrap_bedwall,
    nk_wrap_shortwall and the two nook soffit panels all stop at 102.75 behind it. z is the bbox; the
    true edge comes from `rake`. Rev AZ: 1/2 ply. The BOARD is unchanged at 45 3/4 x 53 3/4 (it is
    still y 4.25 to 50 with hw_sheath_loft_b) but the OPENING CUT inside it moves on two edges,
    because the linings it follows got thinner and the bed-wall lining did not: the far jamb goes
    from 45.75 to 46 (nk_wrap_shortwall is 1/2 now), the near jamb stays on 4.25 (nk_wrap_bedwall
    is still 3/4), and the raked head rides 1/4 higher because the soffit panel is 1/2. The
    opening is therefore 41 3/4 wide, not 41 1/2, and its two jamb returns differ by 1/4.'
- id: hw_sheath_loft_b
  stock: ply-1/2
  x:
  - 102.25
  - 102.75
  y:
  - 46
  - 50
  z:
  - 0
  - 53.75
  role: sheet
  note: 'Rev AD: not a separate piece — the full-height far end of the same board as
    hw_sheath_loft_head, below its raked edge. Out to the finished jamb line so it laps
    the end of nk_wrap_shortwall - 1/2 since Rev AZ, so the line is 46, not 45.75. Its outer end at y 50 meets hw_end_cap''s return, so the
    corner you walk round has no joint in it.'
- id: hw_sheath_stair
  stock: ply-3/4
  x:
  - 106.25
  - 107
  y:
  - 0
  - 50
  z:
  - 24
  - 58
  role: sheet
  kind: raked
  rake:
    profile: stair_top
    side: above
  note: 'Rev AE: ONE board, and only the part of it anyone sees — the answer to "can the new
    stair face be cut from a single sheet". With ledge_end_cap and beam_end_cap fused to it,
    the board is 50 x 44 1/4 (Rev AG took the ledge end to 70 and the beam end to 67 3/4;
    Rev AH dropped the ledge end 3/4 to let the lid lap it, Rev AI took the lid itself to 69)
    and still yields from one 4x8; the Rev AD face was 50 x 66 and needed two.
    It is a SKIRT now, not a sheathed wall: stringer A and the landing box moved out 3/4 onto
    the half-wall framing at 106.25, so this panel starts where they stop. Its bottom edge is
    the `stair_top` profile — 48.75 under the landing box and the stringers'' top run, then
    the tread cuts at 40.5, 32.25 and 24 — and its face at 107 holds the platform''s finished
    line, with the treads and risers trimmed back 3/4 to butt it. Everything the old panel
    covered below that line needed no cover: y 0→3.5 is the nook nailer wall''s own bay, y
    3.5→46.5 is the nook opening and its soffit, y 46.5→50 is inside the understair void.
    Nothing fastens THROUGH it any more — stringer A, lnd_side_member and lnd_rim all bear on
    and screw into the framing direct. Rev AD had it as two boards with a seam on y 8.'
- id: beam_end_cap
  stock: ply-3/4
  x:
  - 106.25
  - 107
  y:
  - 47.75
  - 50
  z:
  - 58
  - 67.75
  role: finish
  note: 'Rev AD: NEW. The beam''s stair end was open above the deck - the stair face stopped
    at 58 and the beam ran to 63, so the end grain faced the landing. It is the top of the
    stair face, not a separate part to fit: with hw_sheath_stair it is one board. Sits on the
    beam''s end (x 106.25) and dies into beam_wrap_face, which already runs to 107. Rev AG:
    9 3/4 tall, was 5, and its inboard edge is the finished face of beam_wrap_inner -
    so it caps the LVL and the inner wrap together and beam_wrap_top has backing under its
    whole width out to x 107. Rev AZ: that face moved to 47.75 with the 1/2 inner wrap, so
    this edge followed it. The cap itself stays 3/4 - it is part of the hw_sheath_stair board,
    which stays 3/4 - so it is 2 1/4 wide now, was 2 1/2. Left at 47.5 it would have stood a
    quarter inch proud of the wrap it is supposed to die flush into, at the one corner of the
    beam you see from the landing.'
- id: hw_rake_nailer
  stock: 2x4
  x:
  - 102.75
  - 106.25
  y:
  - 18.26
  - 46.5
  z:
  - 15.61
  - 41.5
  role: structural
  kind: raked
  rake:
    profile: stringer_underside
    side: above
    band: 1.5
    clip: 41.5
  note: 'Rev X: a 2x4 laid flat in the half-wall''s stud bay, its underside on the stringer
    underside line, so the raked soffit can run out through the wall to the outer face. Runs
    from where the line leaves the header bottom (y 18.26) down to hw_trimmer_b; its upper end
    is bevelled where it dies into the header. Ends where trimmer_b starts — the trimmer backs
    the last 1.5. The 1.5 is measured vertically, as the soffit panel''s is.'
- id: lnd_ledger_bedwall
  stock: 2x8
  x:
  - 106.25
  - 129.5
  y:
  - 0
  - 1.5
  z:
  - 41.5
  - 48.75
  role: structural
  note: 'Rev AE: 23 1/4 long, out to 106.25 with the rest of the box. Rev U: 2x8 like the rest of the box'
- id: lnd_ledger_rightwall
  stock: 2x8
  x:
  - 129.5
  - 131
  y:
  - 0
  - 18
  z:
  - 41.5
  - 48.75
  role: structural
  note: 'Rev U: 2x8; runs to y 18 so stringer C''s plumb cut bears on its end and the rim''s right end hangs on
    its face'
- id: lnd_side_member
  stock: 2x8
  x:
  - 106.25
  - 107.75
  y:
  - 1.5
  - 16.5
  z:
  - 41.5
  - 48.75
  role: structural
  note: 'Rev AE: out 3/4 with stringer A, so it lands flat on the half-wall framing at 106.25
    and its screws go straight into the header instead of through 3/4 of ply facing. It is
    directly over nk_bedwall_stud[0] and beds on nk_bedwall_cap across its full 1.5. Rev U:
    stops at the rim (16.5)'
- id: lnd_joist
  stock: 2x4
  x:
  - 114.75
  - 116.25
  y:
  - 1.5
  - 16.5
  z:
  - 45.25
  - 48.75
  role: structural
  repeat:
    count: 2
    axis: x
    pitch: 7
  note: 'Rev U: two 2x4 joists running with the stringers, hung on the bed-wall ledger and the rim'
- id: lnd_rim
  stock: 2x8
  x:
  - 106.25
  - 129.5
  y:
  - 16.5
  - 18
  z:
  - 41.5
  - 48.75
  role: structural
  note: 'Rev AE: 23 1/4 long, out to 106.25 — stringer A''s plumb cut now meets it across the
    stringer''s full 1.5 (at x 107 it would have caught only 3/4 of it). Rev U: 2x8 rim moved to
    y 16.5–18; stringers extend 9 in under the landing and bear on it full depth (41.5–48.75)'
- id: lnd_ply
  stock: ply-3/4
  x:
  - 107
  - 131
  y:
  - 0
  - 27.875
  z:
  - 48.75
  - 49.5
  role: sheet
  note: 'Rev W: 27 7/8 deep, not 27. The framing line is 27; the riser-6 board is applied to the stringers'' end
    faces at 27→27.75, and the deck noses 1/8 past it exactly as the treads do. Rev V had the member at 27 and
    typed the nose into Drawing 4 as a literal. CUT-LIST: 24 x 27 7/8.'
- id: stringer_a
  stock: 2x12
  kind: stringer
  x:
  - 106.25
  - 107.75
  y:
  - 18
  - 72
  z:
  - 0
  - 48.75
  role: structural
- id: stringer_b
  stock: 2x12
  kind: stringer
  x:
  - 117.875
  - 119.375
  y:
  - 18
  - 72
  z:
  - 0
  - 48.75
  role: structural
- id: stringer_c
  stock: 2x12
  kind: stringer
  x:
  - 129.5
  - 131
  y:
  - 18
  - 72
  z:
  - 0
  - 48.75
  role: structural
  note: 'Rev AE: unmoved. Stringer A went out 3/4 to land on the half-wall framing at 106.25
    and B was recentred to 117 7/8, so the three sit at 106.25 / 117.875 / 129.5 — 11 5/8
    centres, 10 1/8 clear each bay (was 11 1/4 and 9 3/4). The FINISHED stair is still 24
    wide: the treads and risers stop at 107 and butt hw_sheath_stair, which fills 106.25→107
    above the stringers.'
- id: stringer_a_skin
  stock: ply-1/2
  x:
  - 105.75
  - 106.25
  y:
  - 50
  - 72
  z:
  - 0
  - 24
  role: finish
  note: 'Rev AC: closes the understair cavity on the room side - ply on stringer A''s outer
    face, its true outline the stringer''s stepped face carried down to the floor
    (drawings.skin_pts), because below the stringer underside the cavity is open to the room as
    well. z is the bbox. Rev AE: it followed stringer A out, and it now
    starts at y 50 rather than 50.75 - it fills the corner taken out of hw_end_cap and butts
    that cut edge, so the wall''s end return and the skin close the corner between
    them. Its face is set back from the half-wall''s finished stair face at 107, so
    the boards that pass it are wider than the boards uphill of the wall''s end (24); the
    step still falls exactly on the end cap''s face, and tread 3 straddles it and is notched.
    Rev AZ: 1/2 ply, so the face is at 105.75 - 1 1/4 back from 107, was 1 1/2. The lapping
    boards are 25 1/4 (was 25 1/2) and tread 3''s notch is 1 1/4 x 4 3/4 (was 1 1/2 x 5; the
    5 also shortened because the end cap face, which is where the board steps, came in 1/4).
    All of that is DERIVED - drawings/model.py reads this row and hw_end_cap for SKIN_X0 and
    STEP_Y - so the treads and risers followed on their own. CUT-LIST: one stepped panel out
    of 22 x 24, scribed off the stringer in place.'
- id: stringer_a_skin_cleat
  stock: 2x4
  x:
  - 106.25
  - 107.75
  y:
  - 50
  - 63.53
  z:
  - 0
  - 3.5
  role: structural
  kind: raked
  rake:
    profile: stringer_underside
    side: below
    clip: 3.5
  note: 'Rev AE: was a 2x2 that touched nothing at either end - it butted air at y 50.75 and
    died in mid-air at 61 7/8. Now a 2x4 on edge, directly under stringer A (the same 1 1/2
    band, x 106.25-107.75) and 13 1/2 long: its uphill end butts hw_bottom_plate_b - the merged
    shortwall plate - at y 50, and its top is ripped to the stringer underside at the downhill
    end, dying into the stringer where that line reaches the floor at y 63 1/2. Rev AC''s
    reason is unchanged: below the stringer underside the skin has nothing to fasten to for 12
    3/4 of run, and that edge is at shin height. The 2x4 doubles the nailing face to 3 1/2 and
    takes 2x2 off the material list. CUT: one 2x4, 13 1/2 long, one end square, the other a
    42.51 degree rip running 3 3/4 back from the top corner. z is the bbox.'
- id: kicker
  stock: 2x4
  x:
  - 106.25
  - 131
  y:
  - 68.5
  - 72
  z:
  - 0
  - 1.5
  role: structural
  note: 'Rev AE: 24 3/4 long, out to 106.25 with stringer A. Rev W: position FIXED at y 68.5→72, downhill face flush with the stringers'' bottom plumb cut. The
    stringers are notched 1 1/2 x 3 1/2 to hook over it (they are 7.54 deep there, so 6.04 remains — well over the 3 1/2 throat minimum);
    riser 1 sits in front of it at y 72→72.75 and clears it. Rev BB: floor anchorage specified (screws into the
    subfloor, joist location not required) and the three stringers toe-screwed to it — see connections.'
- id: nk_bedwall_stud
  stock: 2x4
  x:
  - 106.25
  - 107.75
  y:
  - 0
  - 3.5
  z:
  - 1.5
  - 40
  role: structural
  repeat:
    count: 3
    axis: x
    pitch: 11.625
  note: 'Rev AE: starts at the half-wall framing (106.25), not 3/4 out from it — the stair-side
    sheathing that used to fill 106.25→107 is gone, so the bay simply runs on to the wall.
    stud[0] is now directly under lnd_side_member, which moved out the same 3/4. Pitch 11.625
    (was 11.25) keeps the three landing flush at 131. Rev Z: standard stud orientation — 1.5
    wide along the wall, 3.5 deep, standing on edge on the flat plate. Non-bearing nailer
    wall; its face at 3.5 is the reveal plane, in line with hw_trimmer_a.'
- id: nk_bedwall_cap
  stock: 2x4
  x:
  - 106.25
  - 131
  y:
  - 0
  - 3.5
  z:
  - 40
  - 41.5
  role: structural
  note: 'Rev Z: a plain 2x4 flat, 3.5 to match the studs. Its top is the landing-ledger plane,
    so lnd_side_member lands on it over x 106.25→107.75 (Rev AE: the cap runs to the half-wall
    framing now, so the side member beds on 2x4 across its full 1.5) and the soffit panel butts
    its face. Now
    that the wall is flush to the bed wall it also runs under lnd_ledger_bedwall over the
    ledger''s full 1.5 depth. BUILD ORDER: lag the ledger to the bed-wall studs first, then
    build this wall up to it and scribe the cap — the cap must not lift the ledger.'
- id: nk_shortwall_strut
  stock: 2x4
  x:
  - 106.25
  - 107.75
  y:
  - 46.5
  - 50
  z:
  - 1.5
  - 15.61
  role: structural
  repeat:
    count: 3
    axis: x
    pitch: 11.625
  note: 'Rev AE: pitch 11.625, was 11.25 — the struts follow the stringers, and stringer A moved
    out to the half-wall framing (106.25) with stringer B recentred to 117 7/8. The three still
    land at exactly x 106.25, 117.875 and 129.5, under stringers A, B and C, so each is a post
    under its stringer rather than backing floating in a bay, and each can be toe-screwed up
    into the stringer it meets. Rev Z: standing on edge, 1.5 wide x 3.5 deep. Tops cut to the
    rake; z is the bbox.'
  kind: raked
  rake:
    profile: stringer_underside
    side: below
- id: nk_wrap_bedwall
  stock: ply-3/4
  x:
  - 102.75
  - 131
  y:
  - 3.5
  - 4.25
  z:
  - 0
  - 41.5
  role: sheet
  note: 'Rev X: one sheet from the half-wall''s outer face through the reveal and on into the
    nook. Runs to the framing plane (41.5); the soffit panel butts its face. Rev Z: out 1/2
    with the reveal — it lands on hw_trimmer_a''s face over the half-wall and on the nook
    studs'' faces beyond, and those are one plane again because of the jamb flitch. Rev AD:
    starts at 102.75, not 102 — recessed so the one-piece nook face laps its end instead
    of butting it. Cut 28 1/4 long, was 29. Its FACE (4.25) is unmoved, so the finished
    opening and everything inside the nook are exactly as they were. Rev AZ/BA: STAYS 3/4
    while nk_wrap_shortwall goes to 1/2, and the reason is a use, not a finish. This is the
    TALL wall of the nook — full height 0 to 41.5, where the short wall tops out under the
    stringers around 16 — so it is the one anyone would hang shelves on, and the builder
    wants the stronger substrate there for that. 3/4 ply takes a screw on its own almost
    anywhere on the sheet; 1/2 does not. That is what makes the nook opening asymmetric
    (finished 4.25 to 46, two jamb returns 1/4 apart) and the asymmetry is accepted for it.
    NOW-OR-NEVER if the shelves might be heavy or high: add blocking between the
    nk_bedwall_stud bays BEFORE this sheet goes on. The 3/4 covers ordinary shelf loads
    anywhere on the face without it, but a real bracket into solid backing is a decision
    that has to be made while the studs are still open. See open-items.'
- id: nk_wrap_shortwall
  stock: ply-1/2
  x:
  - 102.75
  - 131
  y:
  - 46
  - 46.5
  z:
  - 0
  - 16.07
  role: sheet
  kind: raked
  rake:
    profile: stringer_underside
    side: below
  note: 'Rev X: the same sheet on the short wall; its top edge is raked and tucks under the
    stringers. z is the bbox. Rev Z: in 1/2 with the reveal, so the bbox top rose from 15.84
    to 16.3 — it met the stringer undersides half an inch further up the rake. Rev AD:
    recessed to 102.75 with the other two lining sheets; 28 1/4 long, was 29. Rev AZ: 1/2 ply.
    It bears on the same stud faces at 46.5, so it is the FACE that moves: out to 46, and the
    bbox top drops back to 16.07 (a quarter inch downhill on a 8.25/9 rake is 0.23). THE NOOK
    OPENING IS NOW ASYMMETRIC — nk_wrap_bedwall stays 3/4 at the builder''s direction, so the
    finished opening is 4.25 to 46 = 41 3/4 with a 3/4 return on one jamb and 1/2 on the other.
    That difference is only visible where the two returns meet the head, and it is the price of
    keeping 3/4 on the bed-wall side; say so rather than leave it to be found on site.'
- id: nk_soffit_flat
  stock: ply-1/2
  x:
  - 102.75
  - 131
  y:
  - 4.25
  - 18.26
  z:
  - 41
  - 41.5
  role: sheet
  note: 'Rev AE: the flat half of the nook ceiling, its own board — 28 1/4 x 14. It was one
    piece with the raked half (nk_soffit_panel), which meant a sheet with a 42.5 degree kink
    along it: buildable only as a scored-and-folded panel or a lie. The break is at y 18.26,
    where the stringer undersides come down to the ceiling plane. Under the landing box its
    face is the finished ceiling and its top butts the landing framing at 41.5. Rev AZ: 1/2 ply.
    Its TOP stays on 41.5 — it is packed up under the landing framing, which cannot move — so
    the finished nook ceiling RISES 1/4 to 41, and the break at y 18.26 is unchanged because
    face + panel is still 41.5. The nook gains a quarter inch of head.'
- id: nk_soffit_rake
  stock: ply-1/2
  x:
  - 102.75
  - 131
  y:
  - 18.26
  - 46
  role: sheet
  z:
  - 15.57
  - 41.5
  kind: raked
  rake:
    profile: soffit
    side: above
    band: 0.5
  note: 'Rev AE: the raked half of the nook ceiling, on the
    stringer undersides. Its uphill edge is cut plumb at y 18.26 and butts nk_soffit_flat''s
    plumb edge: at the break both faces are on 40.75, so the butt is flush and full-thickness
    and the ceiling reads as one plane turning a corner. (A true 3/4 recess behind the flat
    panel would feather this edge to nothing — the two faces are coplanar at the break.) Rev
    X: it runs the full x 102.75→131 — through the half-wall on hw_rake_nailer, then on the
    stringers — so the rake reads continuously from the outer face. Rev Z: its far edge is
    14.86 above the floor. Rev AD: recessed to 102.75 so the nook face laps its end. Rev AZ:
    1/2 ply, so `band` is 0.5 and the whole raked face drops 1/4 lower against the stringers —
    the far end height goes 14.86 to 15.11. Its downhill edge follows nk_wrap_shortwall out to
    y 46. Still flush and full-thickness at the y-18.26 butt: both halves went to 1/2 together,
    so the two faces are still coplanar at the break.'
- id: slat
  stock: poplar-2x2
  x:
  - 0
  - 1.5
  y:
  - 48.375
  - 49.875
  z:
  - 68.25
  - 94.5
  role: structural
  repeat:
    count: 23
    axis: x
    pitch: 4.7955
  note: 'Rev AN: CENTRED on the beam, y 48.375 to 49.875. The centre line is 49.125, which is
    both the LVL''s centre (48.25 to 50) and the finished beam''s (47.75 to 50.5) - the two
    wrap faces are the same thickness as each other, so the two readings are the same line
    whatever that thickness is. This replaces Rev T''s ''faces flush with wrap'', which had the
    outer face on 50.75 and was only ever an ASSUMED reading of that phrase. The look changes
    deliberately: the screen was one plane with the beam face, and is now a grille set back
    from it on both sides, with a shadow line each side. It also puts every slat screw dead
    centre in the LVL instead of half in the wrap. Rev AG: they start on beam_wrap_top, not at
    63, and all 23 are identical. slat[0] is no longer a special case: the beam runs to x 0
    under it. Rev AZ: the cap is 1/2 ply, so the seat drops to 68.25 and every slat is 26 1/4
    long, was 26. The setback each side is now 5/8, was 7/8. Rev BB: SPECIFY resolved -
    stock key poplar-2x2, matching screen_top_plate''s species (poplar 8/4 S4S, or
    clear/select pine). Same section as a framing 2x2, 1 1/2 x 1 1/2 actual, so no extent
    changed. Source 1 1/2 x 1 1/2 S4S directly if available; otherwise buy the 1 1/2 x 3 1/2
    stock (screen_top_plate''s board) and rip/sand each slat down. Builder''s call, so the
    screen is one wood under one paint, not two.'
- id: screen_top_plate
  stock: poplar-2x4
  x:
  - 0
  - 107
  y:
  - 47
  - 50.5
  z:
  - 94.5
  - 96
  role: structural
  note: 'Rev BA: PAINT-GRADE SOLID STOCK, not an SPF 2x4. Nothing about its job changed - it
    is still structural, still the screen''s top restraint, still 1 1/2 x 3 1/2 - but it is
    fully in view: 3 1/2 of underside and 1 1/2 of edge on each side, the full 107, at eye
    level from the loft and from the room. A framing 2x4''s knots, crown and mill glaze are
    not what you want under paint on the one member that reads as the head of the screen.
    Buy poplar 8/4 S4S, or clear/select pine at the same section; 107 long needs a 10 ft
    board either way, and it is ONE board with no joint - do not splice it, the slats read
    against its bottom edge for the full length. This is the only member in the build in this
    stock. THE SLATS WERE THE SAME QUESTION: 23 exposed painted 2x2s in the same assembly.
    Rev BB decided them the same way, stock key poplar-2x2 - same species, so the screen is
    one wood under one colour, not two.
    Rev AZ: the band moved 1/4 with the wrap, to 47 to 50 1/2, so its outer face is still
    the beam''s finished plane at 50 1/2 and the slats are still set back the same 5/8 top and
    bottom. This is the SAME reading as Rev AS - the plate registers off the wrap face, and the
    wrap face moved - not a reopening of it; the 47 1/4 to 50 3/4 numbers below are that reading
    at the old 3/4 wrap. Nothing in the ceiling gates it: see the access argument below.
    Rev AS: DECIDED - the plate stays on the text reading, and the
    Drawing 3 alternative (46 1/2 to 50 with a 3/4 poplar band) is off the table. What settled it
    is not geometry but access: there is attic space over this ceiling, so blocking can be added
    between joists wherever the plate lands, and the plate no longer has to be positioned to find
    a joist. The ceiling-joist measurement is still worth taking - it tells you whether you are
    screwing to a joist or installing blocking first - but it no longer gates the design.
    HISTORICAL: Text (structure note, Open Items) puts the plate at 47¼→50¾. Drawing 3 draws it 46½→50
    with a ¾ poplar band at 50→50.75 so the finish face matches the wrap. The ceiling-joist measurement targets
    the FRAMING band, so this must be settled before that measurement is useful.

    '
- id: desk
  x:
  - 0
  - 24
  y:
  - 0
  - 55
  z:
  - 0
  - 29
  role: existing
- id: dresser
  x:
  - 115
  - 131
  y:
  - 102
  - 150
  z:
  - 0
  - 36
  role: existing
- id: fan
  x:
  - 38.5
  - 92.5
  y:
  - 66
  - 120
  z:
  - 85
  - 86
  role: existing
  note: blade disc, centre (65.5, 93), r 27 — from Drawing 1
- id: lnd_blocking
  stock: 2x4
  x:
  - 107.75
  - 117.875
  y:
  - 25.5
  - 27
  z:
  - 45.25
  - 48.75
  role: structural
  repeat:
    count: 2
    axis: x
    pitch: 11.625
  note: 'Rev AE: 10 1/8 each, was 9 3/4 — the bays between the stringers grew when A moved out
    and B was recentred. Rev U: 2x4 blocking between the stringers'' top runs, front face
    flush with riser 6 — backs the deck edge and the riser board'
connections:
- a: deck_joist[*]
  b: rear_ledger
  type: hanger
  face: y
  fastener: LUS24
- a: deck_joist[*]
  b: beam
  type: hanger
  face: y
  except:
  - deck_joist[0]
  fastener: LUS24 with 10dx1-1/2 into the beam — 1-1/2 of nail in 1-3/4 of LVL, the thickness
    the hanger tables are written for. Rev AG settles what Rev T left open; joist[0] is
    excepted because it runs past the beam face to y 50 and is carried by the side ledger.
- a: beam_tongue
  b: side_ledger
  type: bearing
  fastener: bears on the ledger top at 57.25 over 1-1/2 x 1-3/4. Pinned with 2 x 1/4 x 6
    structural screws driven UP from below, through the ledger's 3-1/2 into 2-1/2 of LVL —
    set the ledger and joist 0 first, drop the beam on, then screw from the open bay under
    the deck. NOT from above, the way this row read before the Rev AG connection audit, a
    4 in screw from the beam's top face at 67.75 dies at 63.75 and never leaves the beam.
- a: beam_tongue
  b: deck_joist_tail
  type: bearing
  fastener: bears on the sistered joist top over 1-1/2 x 1-3/4. Pinned the same way as the
    ledger half — 2 x 1/4 x 6 up through the joist tail from below. Ledger + joist together
    give the notched end 3 x 1-3/4 = 5.25 sq in, about 115 psi.
- a: deck_joist[0]
  b: side_ledger
  type: face-screw
  face: x
  fastener: '1/4 x 3 structural screws, two rows at 8 in o.c. over the whole 46-3/4 sister,
    with 4 in the last 12 — this is the path that takes joist[0]''s half of the beam
    reaction into the wall'
- a: deck_blocking[*]
  b: beam
  type: face-screw
  face: y
  fastener: '2 x 1/4 x 3 structural screws per block at z 54 1/4 and 56 3/4, driven from the
    beam''s OUTBOARD face at y 50 through 1 3/4 of LVL and 1 1/4 into the block. Rev AY: the z
    is stated because beam_wrap_face''s structural rows come through the same face at the same
    x stations - keep them off each other. Rev AU: preferred over toe-screwing
    from inside the bay because it puts the fastener in shear instead of relying on a toed
    screw, and the y-50 face is open until beam_wrap_face goes on - the heads end up behind
    the wrap. SEQUENCE: before the wrap, and before the deck ply.'
- a: deck_blocking_end
  b: beam
  type: face-screw
  face: y
  fastener: 2 x 1/4 x 3 structural screws from the beam's outboard face, as deck_blocking
- a: deck_ply
  b: deck_blocking[*]
  type: bearing
  fastener: 'construction adhesive + #8 x 1-5/8 at 6 in o.c. along the front edge - the point
    of the blocking. This is the deck diaphragm''s only continuous connection toward the beam
    (Rev AU)'
- a: deck_ply
  b: deck_blocking_end
  type: bearing
  fastener: 'construction adhesive + #8 x 1-5/8 at 6 in o.c., as deck_blocking'
- a: deck_seam_blocking[0]
  b: deck_joist[0]
  type: face-screw
  face: x
  fastener: 2 x 3 in screws toe-driven into deck_joist[0]
- a: deck_seam_blocking[0]
  b: deck_joist[1]
  type: face-screw
  face: x
  fastener: '2 x 3 in screws toe-driven into deck_joist[1]. Rev AY: the far end used to be
    asserted in the other row''s note and never checked. The block has no bearing shelf - it
    hangs at z 55.75-57.25 on toe-screws at BOTH ends - so both ends carry, and both are now
    declared.'
- a: deck_seam_blocking[1]
  b: deck_joist[1]
  type: face-screw
  face: x
  fastener: 2 x 3 in screws toe-driven into deck_joist[1]
- a: deck_seam_blocking[1]
  b: deck_joist[2]
  type: face-screw
  face: x
  fastener: '2 x 3 in screws toe-driven into deck_joist[2]. Rev AY: the far end used to be
    asserted in the other row''s note and never checked. The block has no bearing shelf - it
    hangs at z 55.75-57.25 on toe-screws at BOTH ends - so both ends carry, and both are now
    declared.'
- a: deck_seam_blocking[2]
  b: deck_joist[2]
  type: face-screw
  face: x
  fastener: 2 x 3 in screws toe-driven into deck_joist[2]
- a: deck_seam_blocking[2]
  b: deck_joist[3]
  type: face-screw
  face: x
  fastener: '2 x 3 in screws toe-driven into deck_joist[3]. Rev AY: the far end used to be
    asserted in the other row''s note and never checked. The block has no bearing shelf - it
    hangs at z 55.75-57.25 on toe-screws at BOTH ends - so both ends carry, and both are now
    declared.'
- a: deck_seam_blocking[3]
  b: deck_joist[3]
  type: face-screw
  face: x
  fastener: 2 x 3 in screws toe-driven into deck_joist[3]
- a: deck_seam_blocking[3]
  b: deck_joist[4]
  type: face-screw
  face: x
  fastener: '2 x 3 in screws toe-driven into deck_joist[4]. Rev AY: the far end used to be
    asserted in the other row''s note and never checked. The block has no bearing shelf - it
    hangs at z 55.75-57.25 on toe-screws at BOTH ends - so both ends carry, and both are now
    declared.'
- a: deck_seam_blocking[4]
  b: deck_joist[4]
  type: face-screw
  face: x
  fastener: 2 x 3 in screws toe-driven into deck_joist[4]
- a: deck_seam_blocking[4]
  b: deck_joist[5]
  type: face-screw
  face: x
  fastener: '2 x 3 in screws toe-driven into deck_joist[5]. Rev AY: the far end used to be
    asserted in the other row''s note and never checked. The block has no bearing shelf - it
    hangs at z 55.75-57.25 on toe-screws at BOTH ends - so both ends carry, and both are now
    declared.'
- a: deck_ply
  b: deck_seam_blocking[*]
  type: bearing
  fastener: 'construction adhesive + #8 x 1-5/8 at 6 in o.c. through BOTH panel edges - the
    seam is a butt joint in the deck diaphragm and both sides land on this block (Rev AV)'
- a: deck_ply
  b: side_ledger
  type: bearing
  fastener: 'construction adhesive + #8 x 1-5/8 at 6 in o.c. — structural, not just an edge
    fixing, because the ply diaphragm is what keeps the shallow ledger from rolling under
    the beam''s eccentric load'
- a: deck_ply
  b: rear_ledger
  type: bearing
  fastener: 'construction adhesive + #8 x 1-5/8 at 6 in o.c., same as the side ledger — Rev
    AO drops rear_ledger to deck level so the ply runs over its top the same way'
- a: beam
  b: hw_top_plate_2
  type: bearing
- a: deck_rim
  b: hw_top_plate_2
  type: bearing
- a: rear_ledger
  b: wall:bed
  type: wall
  fastener: '3/8 x 4 lags, 2 per stud staggered, into every stud - the same fastener as
    lnd_ledger_bedwall. Rev AS: was the sizeless ''lags into every stud''. 1 1/2 of 2x4 ledger
    + 5/8 of board = 2 1/8 crossed, 1 7/8 of embedment.'
- a: side_ledger
  b: wall:window
  type: wall
  fastener: 1/4 x 4 structural screws, 2 per stud staggered top and bottom, plus a pair
    within 6 in of y 50 — FIELD, confirm a stud lands there or add blocking in the wall
- a: hw_header
  b: hw_trimmer_a
  type: bearing
- a: hw_header
  b: hw_trimmer_b
  type: bearing
- a: hw_jamb_ply_a
  b: hw_bottom_plate_a
  type: bearing
  fastener: bears with the trimmer; held by the pack nailing below
- a: hw_jamb_ply_b
  b: hw_bottom_plate_b
  type: bearing
  fastener: bears with the trimmer; held by the pack nailing below
- a: hw_trimmer_a
  b: hw_king_a
  type: face-screw
  face: y
  through:
  - hw_jamb_ply_a
  fastener: 16d nails in two rows at 12 in o.c. + construction adhesive on both faces of the
    ply — this is what makes the pack act as one 3.5 post
- a: hw_trimmer_b
  b: hw_king_b
  type: face-screw
  face: y
  through:
  - hw_jamb_ply_b
  fastener: 16d nails in two rows at 12 in o.c. + construction adhesive on both faces of the
    ply — this is what makes the pack act as one 3.5 post
- a: hw_top_plate_2
  b: hw_top_plate_1
  type: bearing
  fastener: 16d at 16 in o.c., staggered — the upper plate laps the lower at the wall's ends
- a: hw_king_a
  b: hw_bottom_plate_a
  type: bearing
  fastener: 2 x 3 in screws toe-driven, or end-nailed 2 x 16d through the plate
- a: hw_king_b
  b: hw_bottom_plate_b
  type: bearing
  fastener: 2 x 3 in screws toe-driven, or end-nailed 2 x 16d through the plate. This is the
    stud the beam's stair-end reaction comes down; Rev AG's connection audit found the post
    asserted in prose and never declared.
- a: hw_top_plate_1
  b: hw_header
  type: bearing
- a: hw_top_plate_1
  b: hw_king_a
  type: bearing
- a: hw_top_plate_1
  b: hw_king_b
  type: bearing
- a: hw_bottom_plate_a
  b: floor
  type: floor
  fastener: '6 x #10 x 3 in screws into the subfloor at roughly 6 in o.c. across the 28
    1/4 run. Rev BB: same builder''s call as the kicker — into the plywood regardless
    of joist location, since the half-wall framing this plate carries is already tied
    into the bed wall and window wall.'
- a: hw_bottom_plate_b
  b: floor
  type: floor
  fastener: '6 x #10 x 3 in screws into the subfloor at roughly 6 in o.c. across the 28
    1/4 run. Rev BB: same builder''s call as hw_bottom_plate_a.'
- a: nk_bedwall_stud[*]
  b: hw_bottom_plate_a
  type: bearing
  fastener: 2 x 3 in screws toe-driven each stud
- a: nk_bedwall_cap
  b: nk_bedwall_stud[*]
  type: bearing
  fastener: 2 x 3 in screws through the cap into each stud
- a: lnd_ledger_bedwall
  b: nk_bedwall_cap
  type: bearing
  fastener: 3 in screws up through the cap into the ledger at each stud — secondary only, the
    ledger's own load path is its lags into the bed-wall studs
- a: lnd_ledger_rightwall
  b: nk_bedwall_cap
  type: bearing
  fastener: 3 in screws up through the cap, at the cap's right-hand end
- a: lnd_side_member
  b: nk_bedwall_cap
  type: bearing
  fastener: 2 x 3 in screws up through the cap into the side member
- a: nk_shortwall_strut[*]
  b: hw_bottom_plate_b
  type: bearing
  fastener: 2 x 3 in screws toe-driven each strut
- a: hw_rake_nailer
  b: hw_trimmer_b
  type: face-screw
  face: y
  fastener: 3 x 3 in screws through the trimmer into the nailer's end
- a: lnd_side_member
  b: hw_header
  type: face-screw
  face: x
  fastener: '6 × 1/4 × 4 structural screws. Rev AE: direct into the header, no 3/4 facing in
    the path, so 4 in reaches the depth 5 in used to.'
- a: lnd_ledger_rightwall
  b: wall:right
  type: wall
  fastener: '1/4 x 4 flat-head structural screws (SDWS22400 or equal), 2 per stud staggered.
    Rev AS: the wall is 5/8 drywall on wood studs, so a screw crosses 1 1/2 of 2x8 ledger +
    5/8 of board = 2 1/8 before it reaches the stud; a 4 leaves 1 7/8 of embedment. Do not
    substitute 3 1/2 here - that is only 1 3/8 in the stud.'
- a: stringer_c
  b: wall:right
  type: wall
  fastener: '1/4 x 4 flat-head structural screws, 2 per stud into every stud the stringer
    crosses. Rev AS: was the bare Rev T phrase ''fastens to the right wall'', which specified
    nothing. Same 2 1/8 of ledger + board to cross as lnd_ledger_rightwall.'
- a: stringer_a_skin
  b: stringer_a
  type: face-screw
  face: x
  fastener: construction adhesive + 1-1/2 x 16ga finish nails at 8 in o.c. into the stringer's outer face (1 in penetration through the 1/2 skin; was 3/4 through 3/4)
- a: stringer_a_skin_cleat
  b: stringer_a_skin
  type: face-screw
  face: x
  fastener: 1-1/2 x 16ga finish nails at 8 in o.c. through the skin into the cleat, plus adhesive
- a: stringer_a_skin_cleat
  b: hw_bottom_plate_b
  type: face-screw
  face: y
  fastener: '2 x #10 x 3 screws through the plate''s end into the cleat'
- a: stringer_a_skin_cleat
  b: stringer_a
  type: bearing
  fastener: 'adhesive + 3 x #10 x 2-1/2 screws up through the cleat''s ripped top into the
    stringer, over the 5 in of angled contact at its downhill end'
- a: stringer_a_skin_cleat
  b: floor
  type: floor
  fastener: '3 x #10 x 3 screws into the subfloor'
- a: kicker
  b: floor
  type: floor
  fastener: '5 x #10 x 3 in screws into the subfloor, roughly 6 in o.c. across the 24 3/4
    run. Floor joist location not measured and not required here: the builder''s call
    (Rev BB) is to fasten straight into the plywood subfloor regardless of where the
    joists fall, since the framing is tied into all three walls in several other places
    and does not depend on this fixing to stay put.'
- a: stringer_a
  b: kicker
  type: bearing
  fastener: 2 x 3 in screws toe-driven into the kicker
- a: stringer_b
  b: kicker
  type: bearing
  fastener: 2 x 3 in screws toe-driven into the kicker
- a: stringer_c
  b: kicker
  type: bearing
  fastener: 2 x 3 in screws toe-driven into the kicker
- a: loft_ceiling
  b: deck_joist[*]
  type: face-screw
  face: z
  panel: true
  fastener: 'construction adhesive + #8 x 2 at 8 in o.c. up into each joist''s 1-1/2 bottom
    edge - 1/2 of ply then 1-1/2 into 3-1/2 of joist (Rev AZ: 1/2 ply, so the same screw takes
    1/4 MORE embedment). Rev AT: the panel had NO connection row of any kind before this.'
- a: loft_ceiling
  b: rear_ledger
  type: face-screw
  face: z
  panel: true
  fastener: 'construction adhesive + #8 x 2 at 8 in o.c. into the ledger''s bottom edge'
- a: loft_ceiling
  b: side_ledger
  type: face-screw
  face: z
  panel: true
  fastener: 'construction adhesive + #8 x 2 at 6 in o.c. into the ledger''s bottom edge over
    the whole 50. Rev AT: tighter than the 8 in field spacing because this is the anchored
    side of the notch tie - see the beam row below.'
- a: loft_ceiling
  b: deck_joist_tail
  type: face-screw
  face: z
  panel: true
  fastener: 'construction adhesive + 2 x #8 x 2 into the tail''s 1-3/4 of bottom edge, the
    other anchored side of the notch tie (Rev AT)'
- a: loft_ceiling
  b: beam
  type: face-screw
  face: z
  panel: true
  fastener: 'construction adhesive + #8 x 2 at 6 in o.c. into the beam''s bottom edge over
    x 3 to 27, then 12 in o.c. beyond. Rev AT: this is the SECOND notch restraint, and it acts
    in the direction the notch would actually fail. A split from the corner at x 3, z 57.25
    runs in +x along the grain, and the piece it separates is the beam''s bottom 3-1/2 beyond
    x 3 - whose bottom face is this z 53.75 line. The same sheet is screwed to side_ledger and
    deck_joist_tail on the other side of x 3, both solidly bearing, so it is a continuous tie
    holding that piece up against members that cannot move. It is SECONDARY to beam_wrap_face,
    which is in the plane of the split and works in shear; this works in screw withdrawal from
    a 1-3/4 landing that is the LVL''s LAMINATED EDGE - screws there cross glue lines, so use
    the stated spacing, do not over-torque, and do not treat this as the primary. Both go on
    late, so neither is present while the loft is being framed.'
- a: beam_wrap_face
  b: beam
  type: face-screw
  face: y
  panel: true
  fastener: 'construction adhesive + #8 x 2 at 12 in o.c. in two rows into the LVL - 1/2 of ply
    then 1-1/2 into 1-3/4 of beam (Rev AZ: the splice screws GAINED 1/4 of embedment on the
    thinner panel; nothing about the splice got weaker). Rev AT: OVER x 0 TO 27 THIS IS STRUCTURAL, not a finish
    fixing: tighten to 6 in o.c. in two rows and glue the full contact area. This panel is the
    notch reinforcement (see beam_tongue) - it straddles the re-entrant corner at x 3, z 57.25
    and runs the full length past the shoulder, so it carries across the corner in shear what
    the LVL would otherwise carry in cross-grain tension. Keep every screw at least 1 in clear
    of the corner and out of the notch void below z 57.25 at x 0-3. Rev AT: the wrap had no
    connection row at all before this - its fixing was never specified and never checked.'
- a: beam_wrap_face
  b: beam_tongue
  type: face-screw
  face: y
  panel: true
  fastener: 'glue only over x 0 to 3 - no screws within 1 in of the notch corner at x 3, z
    57.25, which is what the beam row already says. Rev AY: this row exists so the arithmetic
    covers the whole board. beam_tongue is part_of beam - the SAME LVL - but resolve() does
    not merge part_of members, so beam_wrap_face -> beam checked only 103 1/4 of the 106 1/4
    and the 3 the splice exists to protect sat outside every overlap number reported. Found
    by connection-checker at Rev AX. No physical change: the wood is continuous across x 3
    above z 57.25, and the tongue has its own verified gravity path onto side_ledger and
    deck_joist_tail.'
- a: beam_wrap_face
  b: side_ledger
  type: face-screw
  face: y
  panel: true
  fastener: '#8 x 2-1/2 at 6 in o.c. into the ledger''s y-50 end face, over z 53.75-57.25.
    Rev AT: part of the notch splice - this is what ties the tongue back to the member it
    bears on. End-grain withdrawal is poor and irrelevant here: the joint works in shear.
    Rev AY: 2-1/2 not 2, for 1-3/4 of embedment instead of 1-1/4; Rev AZ makes it 2 on the 1/2 wrap. This is the anchor side of
    the whole splice claim and 1-1/4 of dowel action in end grain was thin.'
- a: beam_wrap_face
  b: deck_joist_tail
  type: face-screw
  face: y
  panel: true
  fastener: '#8 x 2-1/2 at 6 in o.c. into the tail''s y-50 end face, over z 53.75-57.25 - the
    other half of the notch splice, into the joist sistered to the ledger (Rev AT; 2-1/2 since
    Rev AY, same end-grain reason as the ledger half)'
- a: beam_wrap_inner
  b: beam
  type: face-screw
  face: y
  panel: true
  fastener: 'construction adhesive + #8 x 2 at 12 in o.c. into the LVL. Rev AT: finish fixing
    only - this panel starts at z 58, 3/4 above the notch corner, so it does no structural work
    and is not part of the splice. It had no connection row either.'
- a: beam_wrap_top
  b: beam
  type: bearing
  fastener: 'construction adhesive + #8 x 2 at 12 in o.c. into the LVL, between the slats.
    The cap is finish stock doing structural work - it is the slats'' seat - so it is fixed
    on its own account, not by the slat screws alone.'
- a: slat[*]
  b: beam_wrap_top
  type: bearing
  except:
  - slat[22]
  fastener: '1 x #8 x 3 through the cap into the LVL — 1/2 of cap since Rev AZ, 2-1/2 into the beam.
    Rev AG settles what Rev T left open. slat[22] is the one exception - see below.'
- a: slat[22]
  b: beam_wrap_top
  type: bearing
  fastener: '1 x #8 x 3, OFFSET INBOARD. slat[22] runs x 105.5 to 107 and the LVL ends at
    106.25, so only 3/4 of its 1-1/2 width has beam under the cap - the rest is over
    beam_end_cap, which is still 3/4 ply. A centred screw lands half in ply. Found by the kernel ray cast.'
- a: ledge_cleat
  b: wall:bed
  type: wall
  fastener: 2 x 3 in screws into every stud — it carries half an 8 wide lid and whatever is
    set on it, so it is fixed like a ledger, not tacked like trim
- a: ledge_strut[*]
  b: ledge_cleat
  type: face-screw
  face: y
  fastener: '2 x #8 x 2-1/2 toe-driven into the cleat, plus adhesive'
- a: ledge_strut[*]
  b: ledge_front_rail
  type: face-screw
  face: y
  fastener: 'adhesive + 2 pocket screws from inside the well, angled out of the strut into the
    back of the rail. Pocket, not toe: a toe screw into the 3/4 rail from behind breaks out
    the face, and a screw through the rail''s face lands in the strut''s end grain. (Rev BA:
    said "3/4 of poplar"; the rail has been 3/4 paint-grade ply since Rev AS. Same detail,
    same reason - a ply face breaks out at least as readily.)'
- a: ledge_lid
  b: ledge_strut[*]
  type: bearing
  fastener: '#8 x 1-1/4, 2 per strut, countersunk and filled'
- a: ledge_lid
  b: ledge_cleat
  type: bearing
  fastener: '#8 x 1-1/4 at 12 in o.c., countersunk and filled — the lid is fixed, not hinged'
- a: ledge_cleat_rail
  b: ledge_front_rail
  type: face-screw
  face: y
  fastener: 'construction adhesive + #8 x 1-1/4 at 12 in o.c. from inside the well, through
    the cleat into the rail — screwed from the back so nothing shows on the face'
- a: ledge_cleat_rail
  b: deck_ply
  type: bearing
  fastener: 'construction adhesive + #10 x 3-1/2 down through the cleat and the ply into a
    joist at each of the 9 joists, and #8 x 2 into the ply between them'
- a: ledge_lid
  b: ledge_front_rail
  type: bearing
  fastener: '#8 x 1-1/4 at 12 in o.c. into the rail''s 3/4 top edge, countersunk and filled.
    Rev AM: the lid is fixed, never hinged, so this joint is permanent - and with the three
    struts holding the rail''s top on 7.25 it is a flush line the whole 106 1/4, not a joint
    that has to be pulled closed at assembly.'
- a: ledge_rail_splice
  b: ledge_front_rail
  type: face-screw
  face: y
  fastener: 'construction adhesive + #8 x 1-1/4 at 6 in o.c. in two rows, from inside the well
    through the splice into the back of both rail pieces - 1/2 into the rail''s 3/4'
- a: ledge_lid
  b: ledge_end_cap
  type: bearing
  fastener: '#8 x 1-1/4, 2 off — the 3/4 x 8 of skirt top edge the lid laps at the stair end
    (Rev AH)'
- a: screen_top_plate
  b: slat[*]
  type: bearing
  fastener: 'construction adhesive + 1 x #8 x 2-1/2 angled up through the slat into the plate,
    driven from the loft side, countersunk and filled; 2 x 1-1/2 16ga pins each slat to hold it
    while the adhesive cures. Rev AS: was UNSPECIFIED. 16ga alone was proposed and is not enough
    - the structure table calls this screen the GUARD for a 58 deck, and the ceiling note says a
    200 lb lean at its top overloads the slat bases. One real screw per slat at each end (the
    base already has #8 x 3 into the LVL) makes the top a positive connection; the pins are for
    assembly, not for load.'
- a: screen_top_plate
  b: ceiling
  type: ceiling
  fastener: into ceiling framing / blocking — joist location not yet measured
- a: lnd_ledger_bedwall
  b: wall:bed
  type: wall
  fastener: 3/8 x 4 lags, 2 per stud
- a: stringer_b
  b: lnd_rim
  type: face-screw
  face: y
  fastener: 3 x 1/4 x 3-1/2 SDS from inside the box through the rim, before the deck goes on
- a: stringer_c
  b: lnd_ledger_rightwall
  type: face-screw
  face: y
  fastener: plumb cut on the ledger end + 4 x 1/4 x 4-1/2 SDS into right-wall studs
- a: stringer_a
  b: hw_header
  type: face-screw
  face: x
  fastener: '4 x 1/4 x 3-1/2 SDS over y 18-27. Rev AE: the stringer is on the framing now, not
    on 3/4 of ply, so a 3-1/2 buries 2 in the header.'
- a: stringer_a
  b: hw_king_b
  type: face-screw
  face: x
  fastener: 2 x 1/4 x 3-1/2 SDS
- a: stringer_a
  b: hw_trimmer_b
  type: face-screw
  face: x
  fastener: '2 x 1/4 x 3-1/2 SDS. Rev AE: the stringer crosses the far jamb pack over z 12-24,
    so it catches the trimmer as well as the king.'
- a: hw_rake_nailer
  b: stringer_a
  type: face-screw
  face: x
  fastener: 'construction adhesive + 6 x 3 in screws toe-driven through the nailer into the
    stringer''s face. Rev AE: the nailer''s raked end (1-1/2 x 30 on the slope) dies straight
    onto stringer A now that the sheathing between them is gone.'
- a: lnd_rim
  b: hw_header
  type: hanger
  face: x
  fastener: 'HUC28 concealed-flange hanger, SD10212 screws straight into the header (flanges
    would foul the side member on an LUS). Rev AE: no 3/4 facing in the path.'
- a: lnd_rim
  b: lnd_ledger_rightwall
  type: hanger
  face: x
  fastener: HUC28 concealed-flange hanger (an LUS flange would hang past the ledger end)
- a: lnd_joist[*]
  b: lnd_ledger_bedwall
  type: hanger
  face: y
  fastener: LUS24
- a: lnd_joist[*]
  b: lnd_rim
  type: hanger
  face: y
  fastener: LUS24 on the rim's back face
- a: lnd_side_member
  b: lnd_rim
  type: face-screw
  face: y
  fastener: 2 x A35 at the inside corner, installed before the joists
- a: stringer_a
  b: lnd_rim
  type: face-screw
  face: y
  fastener: 2 x 1/4 x 3-1/2 SDS toe-screwed from the stringer's outer face; the side member blocks access from inside
    the box
- a: lnd_blocking[*]
  b: stringer_b
  type: face-screw
  face: x
  fastener: 2 x 3 in screws each end, toe-driven
expected:
  deck_top: 58
  platform_finished:
  - 107
  - 50.5
  clear_below_deck_x: 102.25
  clear_under_joists: 53.25
  clear_under_beam: 53.25
  deck_joist_span: 46.75
  deck_ply:
  - 106.25
  - 48.25
  sitting_headroom: 30
  riser: 8.25
  stair_angle_deg: 42.51
  stringer_throat: 5.17
  stringer_underside_at_27: 33.49
  stringer_underside_at_47: 15.16
  landing_top: 49.5
  landing_headroom: 46.5
  deck_headroom: 38
  nook_opening:
  - 43
  - 41.5
  nook_light_chase: 3.75
  loft_light_chase: 3.5
  nook_far_end_height: 15.11
  rim_header_overlap: 7.25
  rim_stringer_bearing: 7.01
  slat_clear: 3.3
  stair_projection: 72
  # HORIZONTAL reach distance, measured from the platform's FINISHED front face
  # (beam_wrap_face at y 50.5) to the fan disc - not from the slats. Since Rev AN
  # the slats are centred on the beam and their outer face is 49.875, so the screen
  # is 16.125 off the fan; 50.5 is the nearer surface and so the governing one.
  # Rev AZ: the 1/2 wrap moved that face in 1/4, so the reach GREW to 15.5.
  fan_clearance: 15.5
  room_depth_chain: 186
  screen_top_plate_band:
  - 47
  - 50.5
