galenandrew/wills-loft-bed/(commit log)

2026-09-04 Rev U - Stair Stringer/Landing Framing
2026-09-05 Add cad/ — a build123d kernel layer derived from dimensions.yaml
    Time-boxed spike per cad/BRIEF.md, scoped to the stair and landing. The yaml
    stays the single source of truth; nothing here replaces verify.py, drawings/
    or site/. Stair geometry is imported, never re-derived — verify.Stair and
    drawings.model.stringer_pts() are the only sources.
    model.py yaml → solids; stringers extruded from the true notched profile,
    plus treads/risers/soffit/header laminations the yaml lacks
    section.py plane cuts + hidden-line removal, emitted in svgview.View's own
    inch coordinates so a kernel figure lands on the sheet 1:1
    check.py solid interference, minimum di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
2026-09-05 Rev W — tread/riser joinery corrected, stringers notched over the kicker
    The tread/riser joint was specified three different ways in three places. The
    kernel settled it by probing the solid: material is UPHILL of every plumb notch
    and air is downhill, so the riser board goes IN FRONT of the cut (y1 → y1+3/4)
    with its bottom edge on the stringer's horizontal cut for the tread below, and
    that tread starts where the riser ends and butts its face. Riser behind the
    tread, simple butt joint, nothing notched.
    Rev V's note described the opposite arrangement; draw_treads() drew a third
    thing — the riser recessed INTO solid stringer, which would have needed ten
    pocket-cut riser pieces instead o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
    [dimensions.yaml]
2026-09-05 Port Drawing 4's cut layer to the kernel, with an input-hashed cache
    d4()'s six hand-enumerated cut calls — four R(), v.poly(stringer_pts()) and
    draw_treads() — collapse to one kernel_cut(v, "x", CUT_X, skip=("soffit_panel",)).
    The plane decides what it crosses; the sheet no longer lists members, so a member
    added to the landing box shows up without touching this file. Styling defaults by
    stock (framing hatched, sheet goods plain) and a sheet overrides per member.
    Geometrically identical to the hand-drawn sheet: 29 shapes before and after, worst
    deviation 0.0000", nothing added or missing. The SVG differs structurally (cut
    faces come back as loops, so 13 rects + 16 polygons where there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
2026-09-05 Mirror the CAD export into a right-handed room frame
    The exported STL/STEP had the half-wall on the wrong side of the stair.
    Cause: dimensions.yaml's axes are LEFT-handed as they map onto the room. Facing
    the closet wall (+y) the window wall (x = 0) is on your right, so yaml +x runs to
    your left and x × y = -z. The labelling is not wrong — facing the BED wall, +x
    really is on your right, which is the vantage the sheets are read from — it is
    just a left-handed pairing.
    Harmless in 2D: every figure maps two yaml axes onto the page, and once the frame
    is read correctly all twelve are right. The plans are true from-above plans,
    Drawing 4's half-wall genuinely is in front of the cut at x 1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
2026-09-05 Export Y-up preview copies alongside the Z-up CAD model
    Previewing model.step showed the bed wall as the bottom plane and the ceiling as
    the front. Not handedness — left/right were correct, so to_room_frame() is fine.
    The room frame is Z-up (the CAD convention: FreeCAD, Fusion, SolidWorks) while
    Quick Look and most web/STL previewers assume Y-up, and so render a Z-up model
    lying on its back.
    export.to_preview_frame() rotates -90 degrees about X: (X, Y, Z) -> (X, Z, -Y). A
    rotation, so handedness is preserved. Floor -> Y 0, ceiling -> +Y, bed wall -> Z 0
    with the closet running to -Z, so a previewer's default front view looks at the bed
    wall — the vantage the sheets are read from.
    cad.s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
2026-09-05 Revert Y-up preview exports; keep the export Z-up and standard
    Z-up is the CAD convention and the export stays there. A previewer that assumes
    Y-up gets rotated in the viewer rather than the model being bent to fit it.
2026-09-05 CLAUDE.md: never commit unprompted — the user reviews first
    Applies to amend and revert as well. Make the change, report it, suggest a
    commit if warranted, and wait for the explicit command.
2026-09-05 Fix outer dimension offsets
    [dimensions.yaml]
2026-09-06 Fix nook wall framing and loft bed boxed ledge notch
    [dimensions.yaml]
2026-09-06 Update stairs/landing framing to attach to half wall framing
2026-09-06 Reworked beam to LVL
    [dimensions.yaml]
2026-09-06 Reworked boxed ledge and added inner cleats for attachment
    [dimensions.yaml]
2026-09-06 Restructure project to fully incorporate CAD model rendering/validation
    [model.stl]
2026-09-06 Misc cleanup from prior revisions
    LVL Nominal sizes and fan -> nearest slat
2026-09-06 Center mattress on loft opening for bed
2026-09-07 Make the fan a circle in room.step
2026-09-07 Add Materials list and helpers
    [materials-list.xlsx]
2026-09-07 Clarify some materials and cuts
    Boxed ledge as ply and splice addition
    [model.stl]
2026-09-07 Resolved concern on beam notch and identified several missing connection rows
    [materials-list.xlsx]
2026-09-07 Rev AT: notch reinforcement is the wrap and the ceiling, plus a fastener schedule
    The beam's window end is notched 3 x 3-1/2 out of its bottom corner so it can
    sit on the side ledger and the sistered joist. LVL makers prohibit bottom
    notches, and Rev AG's answer was a 3/4 ply cheek on the INBOARD face running 24
    past the shoulder. That cannot be built: deck_ply fills y to 48-1/4 at
    z 57-1/4 to 58, straight across the re-entrant corner, and deck_joist[1] and [2]
    run out to y 48-1/4 well inside the 24. It was also never a member, so it was in
    no drawing, no clash check and no takeoff.
    Two panels already in the design do the job better, from the two faces the
    notch can move relative to:
    bea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
2026-09-07 Rev AU: deck-ply front-edge blocking at the beam
    Nine 2x4 blocks on edge at the beam face -- the last thing standing between the
    model and a cut list, and a recommendation in open-items for several revisions.
    Why it matters is easy to miss from the drawings: the joists HANG off the beam
    on LUS24s rather than bearing on it, so their ends stop at the LVL face and the
    deck ply's front edge arrived there with nothing under it and nothing fastening
    it. The deck is the anti-roll diaphragm that stands in for posts -- glued and
    screwed to the rear ledger and the side ledger, and connected to the beam at
    zero points. Bending was never the issue; 3/4 ply spans 10-1/2 without noticing.
    The diaphragm w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
    [materials-list.xlsx, model.stl]
2026-09-07 Revs AV-AX: nest the sheet goods, re-cut the deck and ceiling ply
    [materials-list.xlsx, model.stl]
2026-09-07 Rev AY: drawing-auditor and connection-checker run
    [materials-list.xlsx]
2026-09-07 Change to 1/2" ply for several finished surfaces
    [materials-list.xlsx, model.stl]
2026-09-07 Cleaned up staps in HW diagram and ran audit
    [materials-list.xlsx]
2026-09-07 Update CAD models from mm to inches
    [model.stl]
2026-09-07 Update sheet note re kerf and factory edge; remove dead function
    [materials-list.xlsx]
2026-09-07 Moved and restructured Open Items
    [materials-list.xlsx]
2026-09-08 Rev BB: close six Open Items on builder's word
    Specify-not-redesign: kicker and both half-wall bottom plates now
    fasten straight into the subfloor regardless of floor joist location
    (not being measured); stringers toe-screwed to the kicker on top of
    the existing notch bearing; slats get a new poplar-2x2 stock key
    matching screen_top_plate's species; ply grade closed as paint-grade,
    sourced locally; room depth stays at the assumed 186.
    The stud-location item narrows from a three-wall survey to the one
    point that matters: window-wall stud within 6 in of y 50 (from the
    bed-wall corner), for the beam's end reaction.
    NOW-OR-NEVER moves out of Open Items to a new Appendix card,
    content/sequencin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
    [dimensions.yaml]
2026-09-09 Rev BC: electrical layer, v2 reference pages, and two silent-failure fixes
    MODEL
    Rev BC places the room's electrical in dimensions.yaml. A device is a point on a
    named member's face plus the box behind it: `face` is the direction it looks,
    `box` is [w, h, depth] running into the wall, `lets_into` names every member the
    box is cut into. verify.check_electrical asks the three things that go wrong —
    is it on the face it claims, is a `centred` one really centred, does its box hit
    anything undeclared — reading a raked member's TRUE envelope over the box's own
    y span rather than its bounding box.
    · nook light, confirmed at the centre of the flat nook ceiling. The 3-3/4 chase
    above the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
    [dimensions.yaml]
2026-09-09 Rev BC.1: Cut list page, shared takeoff, page titles, Drawing 8 labels
    Drawing-only — no member moved, verify unchanged at 0 FAIL 0 WARN.
    CUT LIST
    The takeoff moved out of tools/materials.py into takeoff.py at the root: every
    solid the kernel says gets cut, packed into boards and nested onto 4x8 sheets,
    plus the hardware tally. The xlsx workbook and the new v2 Cut list page now read
    ONE takeoff instead of two copies of the same nest. Cached in .kernel-cache the
    way sheets/geometry.py caches its views, and build123d is imported only on a
    miss, so the build stays at 0.05s until the model actually moves.
    sheets/cutlist.py draws each of the nine sheets at true size as its own figure,
    tiled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
    [materials-list.xlsx]
2026-09-09 Rev BD: close framing species/grade and light fixture SPECIFY items; move Open items page
    Framing species and grade left to the builder to source locally, no
    model value depends on it. Light fixtures: the three remaining
    loft_lighting wafers confirmed as low-profile canless wafers with 1/2"
    clearance in the 3.5" chase, matching the nook light confirmed at Rev
    BC — dimensions.yaml note no longer reads ASSUMED. Both items moved
    from Open items to Closed.
    site-v2 page order: Open items moved from right after Loft & screen to
    between Fasteners and Appendix.
    [dimensions.yaml]
2026-09-09 Make sheet nesting cut line thinner
2026-09-09 Make Box Ledge its own component and couple labels with components
